Acadevic/RocketStoveDesign/README.md

This project is the creation of a rocket stove.
