Acadevic/RocketStoveDesign/Conference Paper/SAUPEC26-30-Paper.odt

Design and Validation of a Sustainable Rocket Stove for Off-Grid Cooking and Heating in Underprivileged Communities

*Note: Sub-titles are not captured in Xplore and should not be used

line 1: 1st Given Name Surname
line 2: dept. name of organization
(of Affiliation)
line 3: name of organization
(of Affiliation)
line 4: City, Country
line 5: email address or ORCID

line 1: 4th Given Name Surname
line 2: dept. name of organization
(of Affiliation)
line 3: name of organization
(of Affiliation)
line 4: City, Country
line 5: email address or ORCID

line 1: 2nd Given Name Surname
line 2: dept. name of organization
(of Affiliation)
line 3: name of organization
(of Affiliation)
line 4: City, Country
line 5: email address or ORCID

line 1: 5th Given Name Surname
line 2: dept. name of organization
(of Affiliation)
line 3: name of organization
(of Affiliation)
line 4: City, Country
line 5: email address or ORCID

line 1: 3rd Given Name Surname
line 2: dept. name of organization
(of Affiliation)
line 3: name of organization
(of Affiliation)
line 4: City, Country
line 5: email address or ORCID

line 1: 6th Given Name Surname
line 2: dept. name of organization
(of Affiliation)
line 3: name of organization
(of Affiliation)
line 4: City, Country
line 5: email address or ORCID

Abstract: Sustainable off-grid cooking remains a significant challenge for engineers: solar stoves are often too slow, while open fires are inefficient and resource-intensive. This study develops a cost-effective and safe rocket stove for frugal off-grid cooking in underprivileged communities, offering a practical alternative that delivers efficient cooking performance, preserves cultural practices, and provides a low-cost solution. An iterative approach was followed, involving requirements analysis, laboratory testing, field testing, and prototyping. The final requirements identified cooking and space heating as primary needs. Prototypes were designed and refined to assess thermal behavior according to ISO 19867, cooking capabilities following ISO 1860-1, and environmental performance using life-cycle assessment (ISO 14040). Field trials were then conducted to evaluate social integration and stakeholder satisfaction. The research resulted in the development of a sustainable, low-cost rocket stove design that complies with international standards Laboratory tests in accordance with ISO standards established safe thermal behavior, ensuring the shell remained safe to touch while enabling slow heat release for space heating. Field tests evaluated social integration and stakeholder satisfaction. Findings suggest that rocket stove technology holds considerable potential to improve cooking practices and provide household heating for South African communities lacking access to the national power grid.

Keywords—component, formatting, style, styling, insert (key words)

# Introduction

It is well known that much of Southern Africa is sparesly populated. This is not reflected in the average population per square meter since many of the large cities have now experienced rapid urbanisation. Yet, small communities still persist due to culutural nomadism or historic economic reasons such as farm hands, settlements, and towns.

1. Modest energy needs across much of the region.
  Home solarPV systems are well suited for rural settlements as they have modest energy needs of around 100 watts (Barnes et al., 2009), considering lighting, household appliances, computers, and water pumps . Note the exclusion of thermal loads.
  1. While much of the regions industrial sectors prioritize renewable energy for economic sustainability reasons (Steed et al., 2025), rural african’s do not benefit from this transition. These complexities of rural finances mean completely different financial models and incentives are being investigated (Dibaba et al., 2023).
  2. Energy justice and the JET
2. Challenges of energy infrastrucutre in micro-communities
3. The benefits of energy introduced micro-communities
  1. Social
  2. Entrepreneurial
  3. Economic, through adoption
4. Fragmented efforts and the advantage of an open platform for such integration
  Swarm grids are envisioned as a peer-to-peer energy sharing platform (Sheridan et al., 2023).
  Previous efforts like developed a SolarPV (Vermaak et al., 2025)

A roadmap is a “”

# Method

## Roadmap

A

First, confirm that you have the correct template for your paper size. This template has been tailored for output on the A4 paper size. If you are using US letter-sized paper, please close this file and download the Microsoft Word, Letter file.

## Phase 1: Solar PV for lighting and smartphone charging

The first phase of this project developed a cost-effective solar PV prototype[^1]. The prototype was installed in a community and the feedback was evaluated. The resulting post implementation feedback demonstrated the prototype met the user needs, but elicited that the community appetite was increasing.

## Phase 2: Rocket stoves for cooking and demand profiling

Recalling that in phase 1, solarPV cooking was infeasible this phase introduced a woodfired rocket stove for cooking.

### Rocket stove

This stove was designed for low-cost cooking and environmental sustainability. Secondary safety and space heating emerged as feasible requirements and were persued.

For example, local material and manufacturing methods were used. Local brush/wood was used for fuel and sand and rock was used to create a thermal battery for insulation.

### Demand profiling

As users familiarty with energy grows, so does their appetite. While many demand profile synthesizers are available for industrial systems, fewer are available for residential, and none (to the authors knowledge) are available for rural energy users. This may be due to a lack of data. Therefore, the next requirement is the measuring and monitoring of users energy usage patterns to better aid in sizing energy systems and detecting when a capacity upgrade is neededed. Feasibility revealed that this subsystem can also be used to tarrif the user, which may lead to business opportunity by monetizing the nano-energy grid.

# Results

# Conclusion

##### Acknowledgment (Heading 5)

The preferred spelling of the word “acknowledgment” in America is without an “e” after the “g”. Avoid the stilted expression “one of us (R. B. G.) thanks ...”. Instead, try “R. B. G. thanks...”. Put sponsor acknowledgments in the unnumbered footnote on the first page.

##### References

The template will number citations consecutively within brackets [1]. The sentence punctuation follows the bracket [2]. Refer simply to the reference number, as in [3]—do not use “Ref. [3]” or “reference [3]” except at the beginning of a sentence: “Reference [3] was the first ...”

Number footnotes separately in superscripts. Place the actual footnote at the bottom of the column in which it was cited. Do not put footnotes in the abstract or reference list. Use letters for table footnotes.

Unless there are six authors or more give all authors’ names; do not use “et al.”. Papers that have not been published, even if they have been submitted for publication, should be cited as “unpublished” [4]. Papers that have been accepted for publication should be cited as “in press” [5]. Capitalize only the first word in a paper title, except for proper nouns and element symbols.

For papers published in translation journals, please give the English citation first, followed by the original foreign-language citation [6].

1. G. Eason, B. Noble, and I. N. Sneddon, “On certain integrals of Lipschitz-Hankel type involving products of Bessel functions,” Phil. Trans. Roy. Soc. London, vol. A247, pp. 529–551, April 1955. (references)
2. J. Clerk Maxwell, A Treatise on Electricity and Magnetism, 3rd ed., vol. 2. Oxford: Clarendon, 1892, pp.68–73.
3. I. S. Jacobs and C. P. Bean, “Fine particles, thin films and exchange anisotropy,” in Magnetism, vol. III, G. T. Rado and H. Suhl, Eds. New York: Academic, 1963, pp. 271–350.
4. K. Elissa, “Title of paper if known,” unpublished.
5. R. Nicole, “Title of paper with only first word capitalized,” J. Name Stand. Abbrev., in press.
6. Y. Yorozu, M. Hirano, K. Oka, and Y. Tagawa, “Electron spectroscopy studies on magneto-optical media and plastic substrate interface,” IEEE Transl. J. Magn. Japan, vol. 2, pp. 740–741, August 1987 [Digests 9th Annual Conf. Magnetics Japan, p. 301, 1982].
7. M. Young, The Technical Writer’s Handbook. Mill Valley, CA: University Science, 1989.

IEEE conference templates contain guidance text for composing and formatting conference papers. Please ensure that all template text is removed from your conference paper prior to submission to the conference. Failure to remove template text from your paper may result in your paper not being published.

hgjgh

[^1] Note that prototype in this context means a fully functioning product/system.
