Acadevic/RocketStoveDesign/CAD/Design Images/Screenshot 2025-10-03 093657.jpg

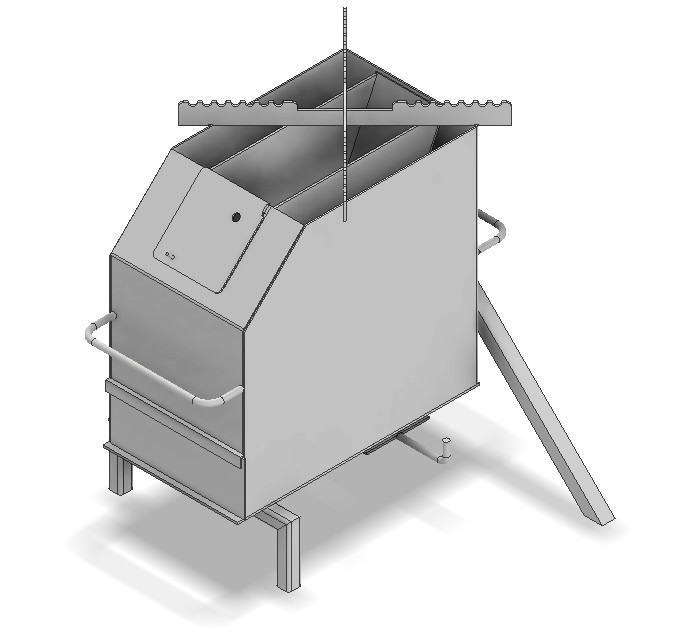
CAD/Design Images/Screenshot 2025-10-03 093657.jpg
