Acadevic/RocketStoveDesign/CAD/Design Images/View1 (1).png

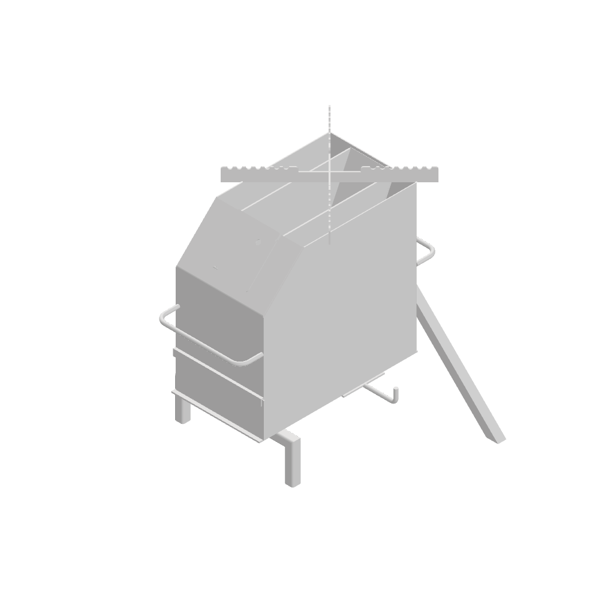
CAD/Design Images/View1 (1).png
