Acadevic/RocketStoveDesign/CAD/Design Images/View1 (2).png

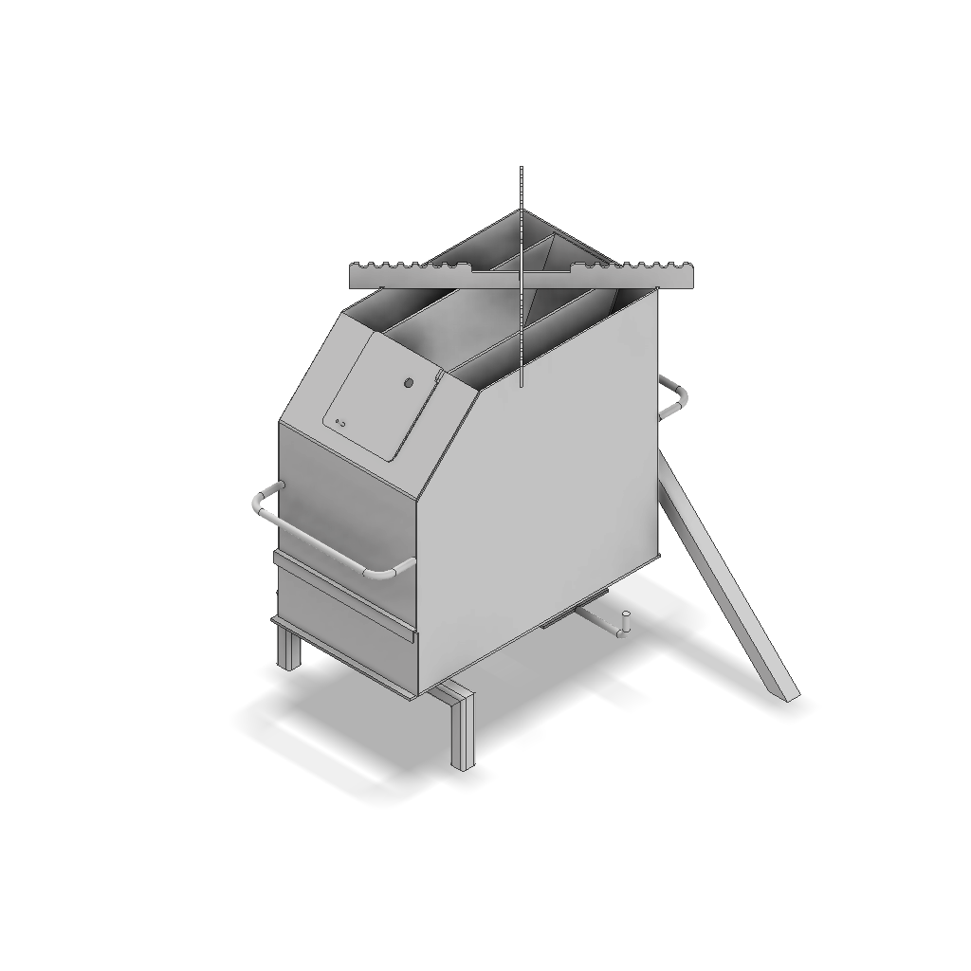
CAD/Design Images/View1 (2).png
