Acadevic/RocketStoveDesign/CAD/Design Images/View1 (3).png

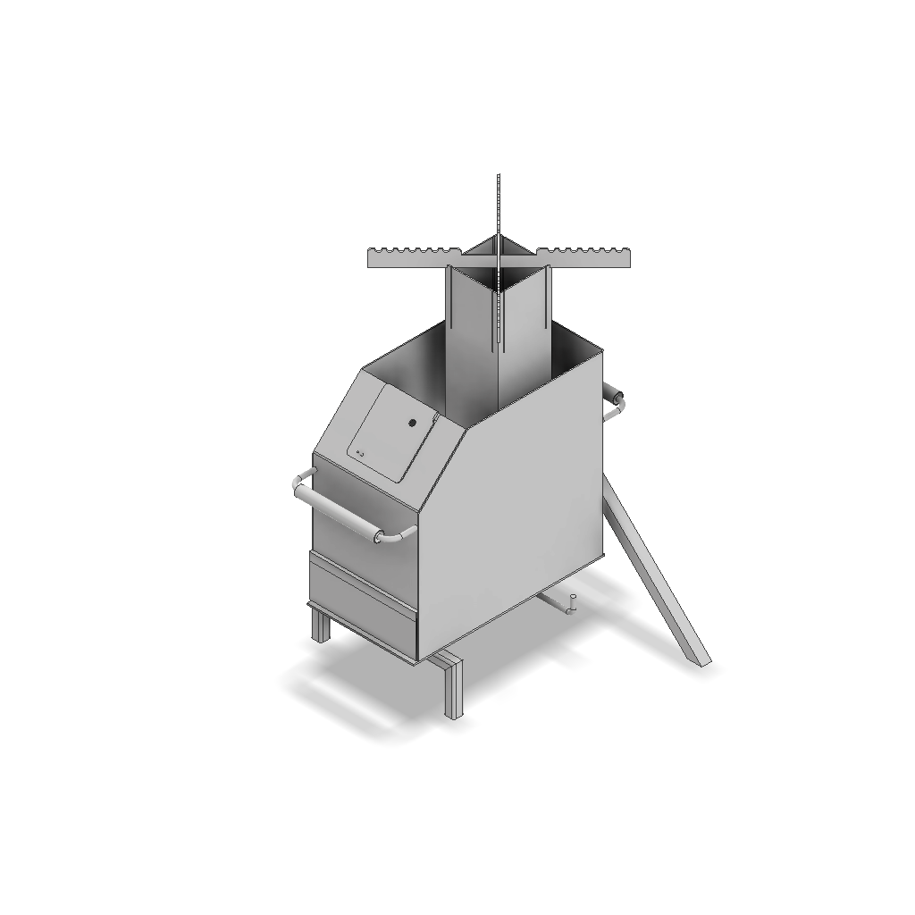
CAD/Design Images/View1 (3).png
