Acadevic/RocketStoveDesign/CAD/CAD Final Design/Workshop Blueprints/Lazercut-Parts.pdf

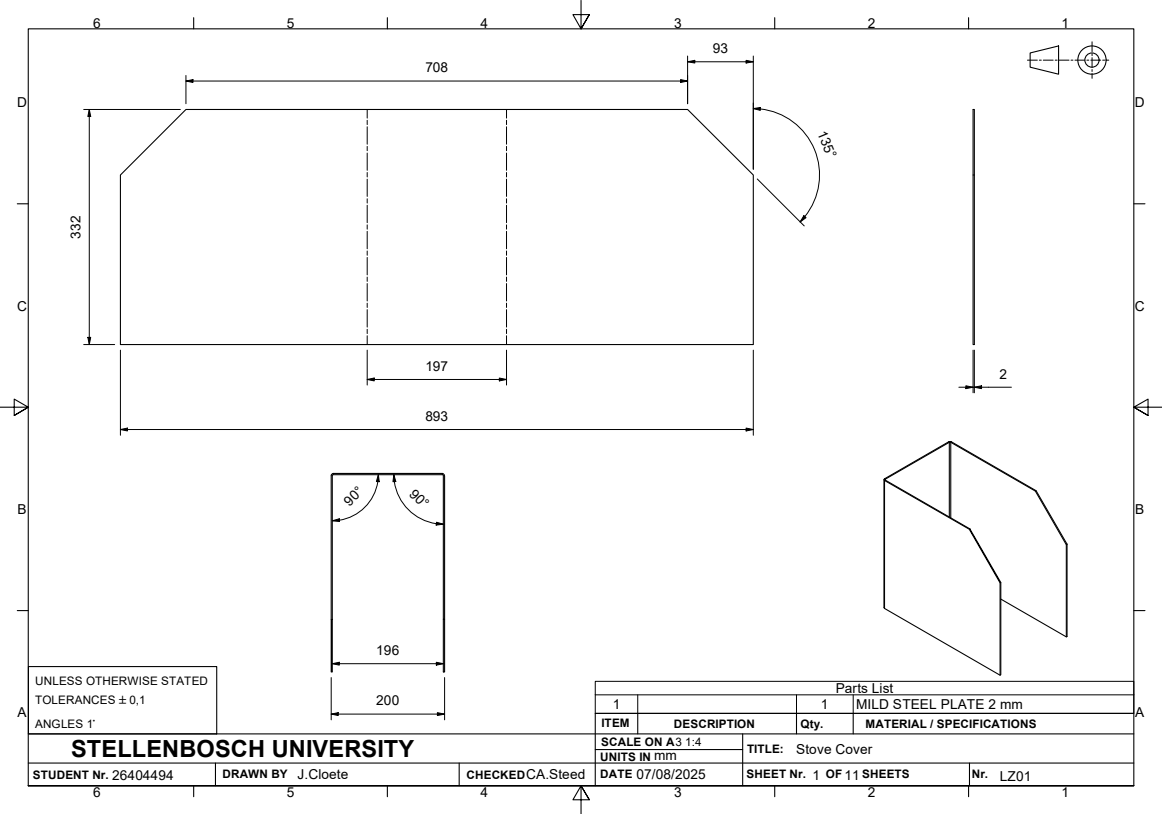
[picture p5: page 1]
Parts List; STUDENT Nr.; DRAWN BY; CHECKED; UNITS IN; SHEET Nr.; SHEETS

UNLESS OTHERWISE STATED
TOLERANCES `0,1
ANGLES 1~

1 | | 1 | MILD STEEL PLATE 2 mm
ITEM | DESCRIPTION | Qty. | MATERIAL / SPECIFICATIONS

STELLENBOSCH UNIVERSITY | SCALE ON A 3 1:4 | TITLE: Stove Cover

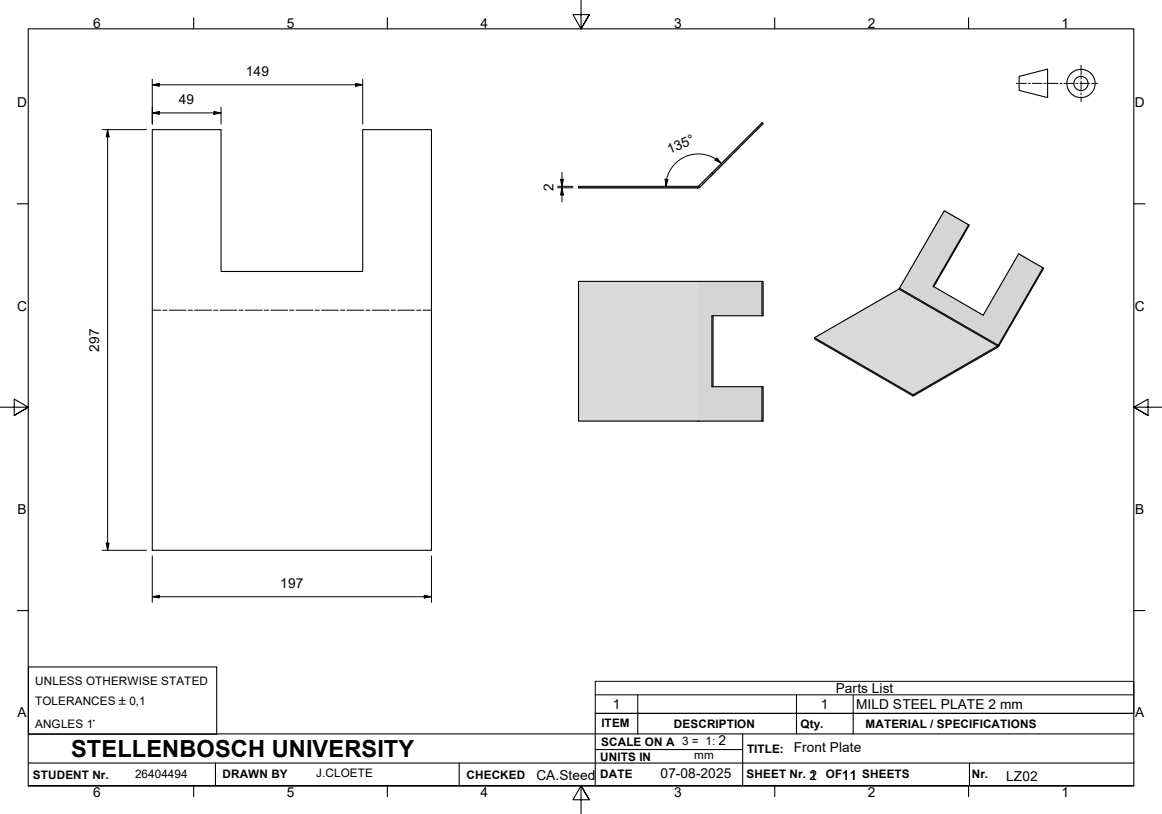
[picture p6: page 2]
Parts List

UNLESS OTHERWISE STATED
TOLERANCES `0,1
ANGLES 1~

1 | | 1 | MILD STEEL PLATE 2 mm
ITEM | DESCRIPTION | Qty. | MATERIAL / SPECIFICATIONS

STELLENBOSCH UNIVERSITY | 3 = 1: 2 SCALE ON A | Front Plate

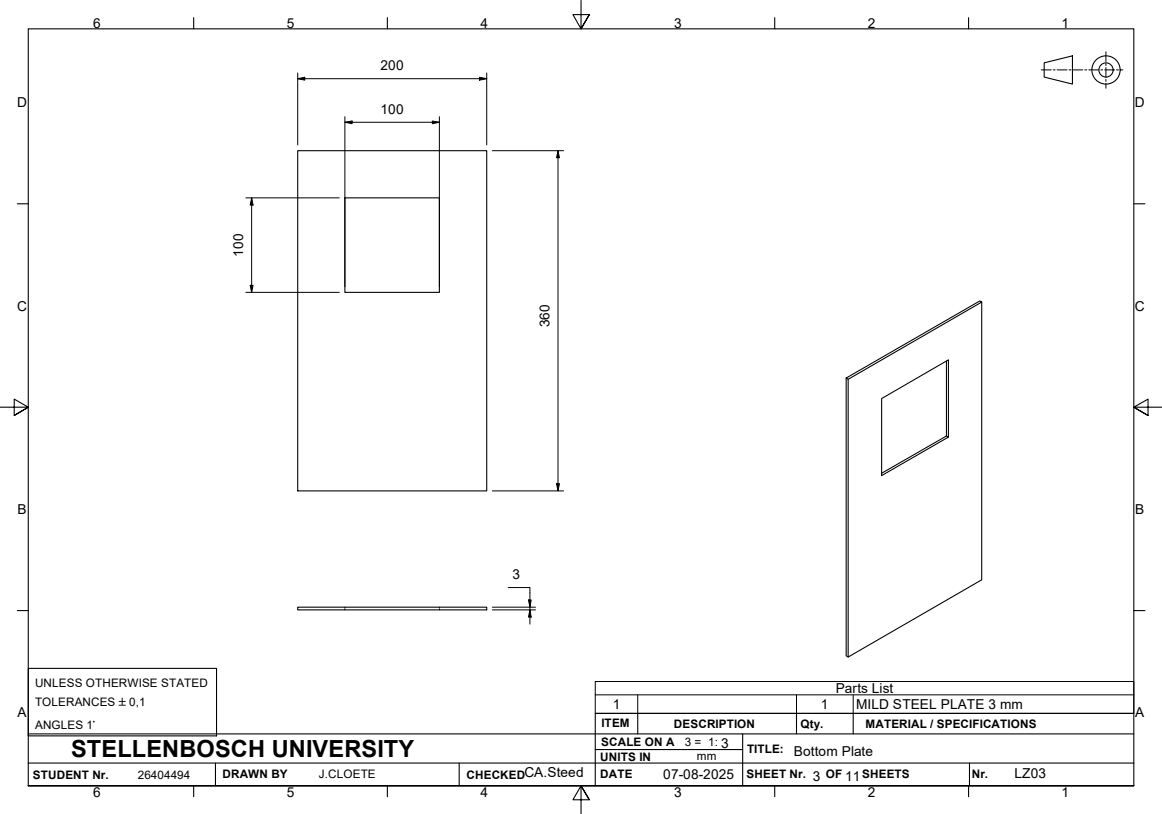
[picture p7: page 3]
Parts List

UNLESS OTHERWISE STATED
TOLERANCES `0,1
ANGLES 1~

1 | | 1 | MILD STEEL PLATE 3 mm
ITEM | DESCRIPTION | Qty. | MATERIAL / SPECIFICATIONS

STELLENBOSCH UNIVERSITY | SCALE ON A 3 = 1: 3 | Bottom Plate

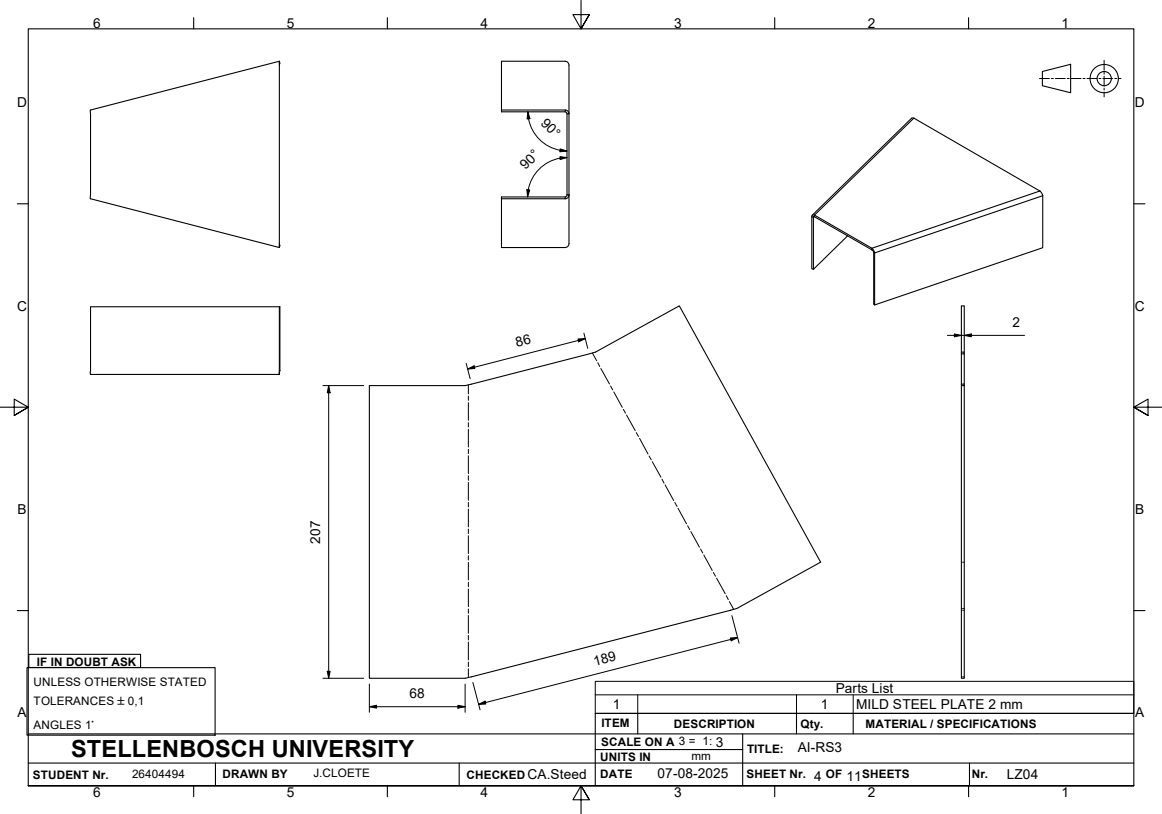
[picture p8: page 4]
Parts List

IF IN DOUBT ASK
UNLESS OTHERWISE STATED
TOLERANCES `0,1
ANGLES 1~

1 | | 1 | MILD STEEL PLATE 2 mm
ITEM | DESCRIPTION | Qty. | MATERIAL / SPECIFICATIONS

STELLENBOSCH UNIVERSITY | 3 = 1: SCALE ON A 3 | AI-RS3

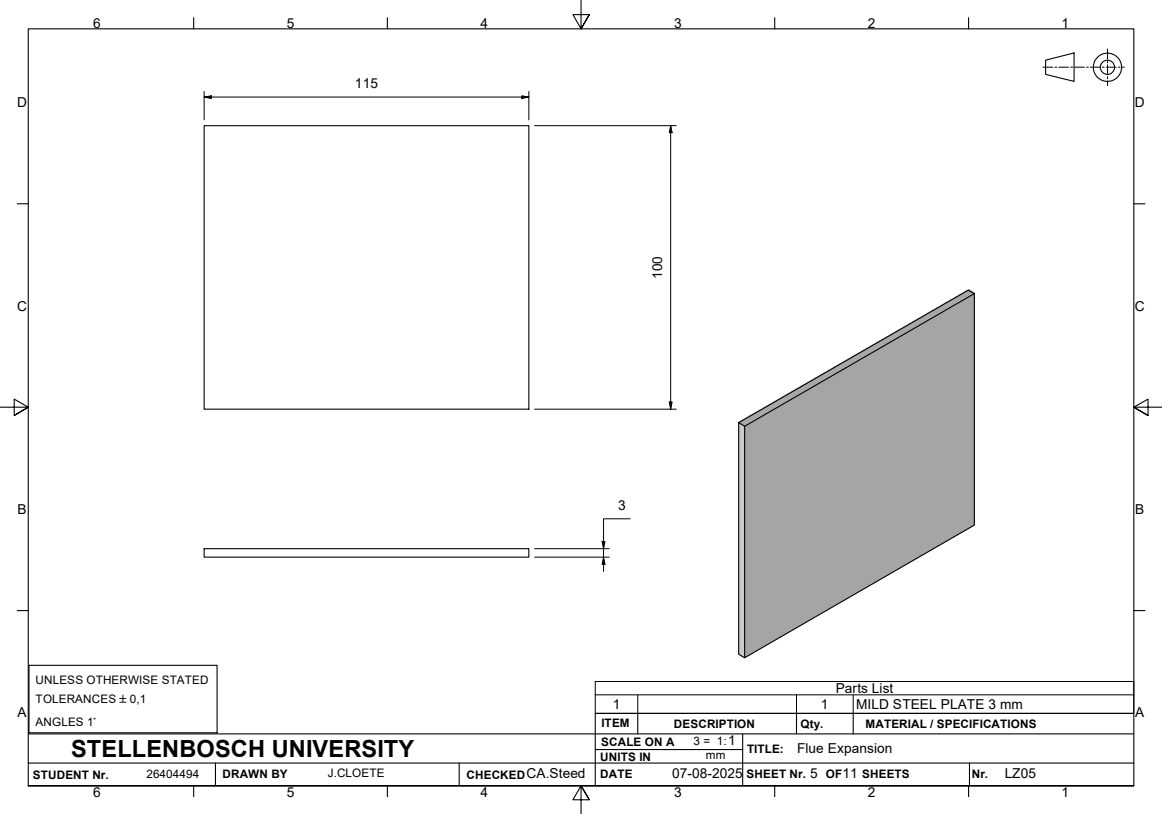
[picture p9: page 5]
Parts List

UNLESS OTHERWISE STATED
TOLERANCES `0,1
ANGLES 1~

1 | | 1 | MILD STEEL PLATE 3 mm
ITEM | DESCRIPTION | Qty. | MATERIAL / SPECIFICATIONS

STELLENBOSCH UNIVERSITY | 3 = 1: 1 SCALE ON A | Flue Expansion

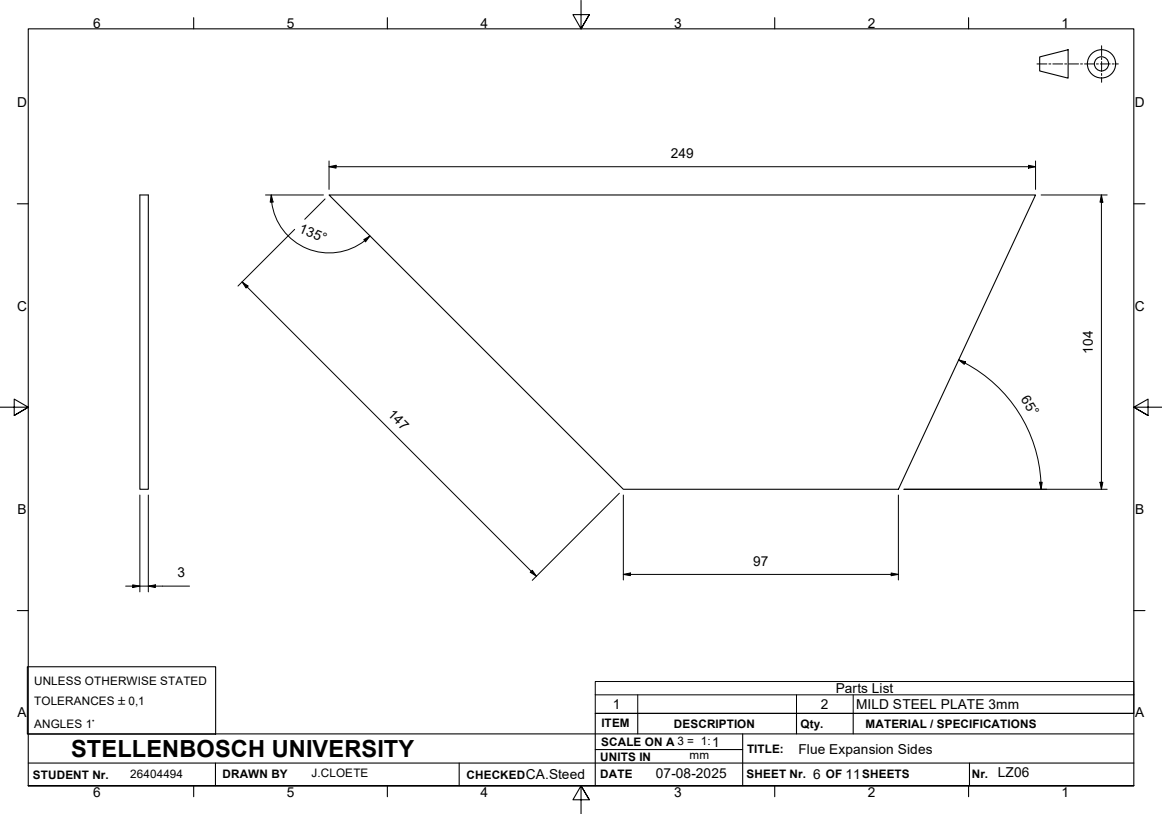
[picture p10: page 6]
Parts List

UNLESS OTHERWISE STATED
TOLERANCES `0,1
ANGLES 1~

1 | | 2 | MILD STEEL PLATE 3mm
ITEM | DESCRIPTION | Qty. | MATERIAL / SPECIFICATIONS

STELLENBOSCH UNIVERSITY | 3 = 1: SCALE ON A 1 | Flue Expansion Sides

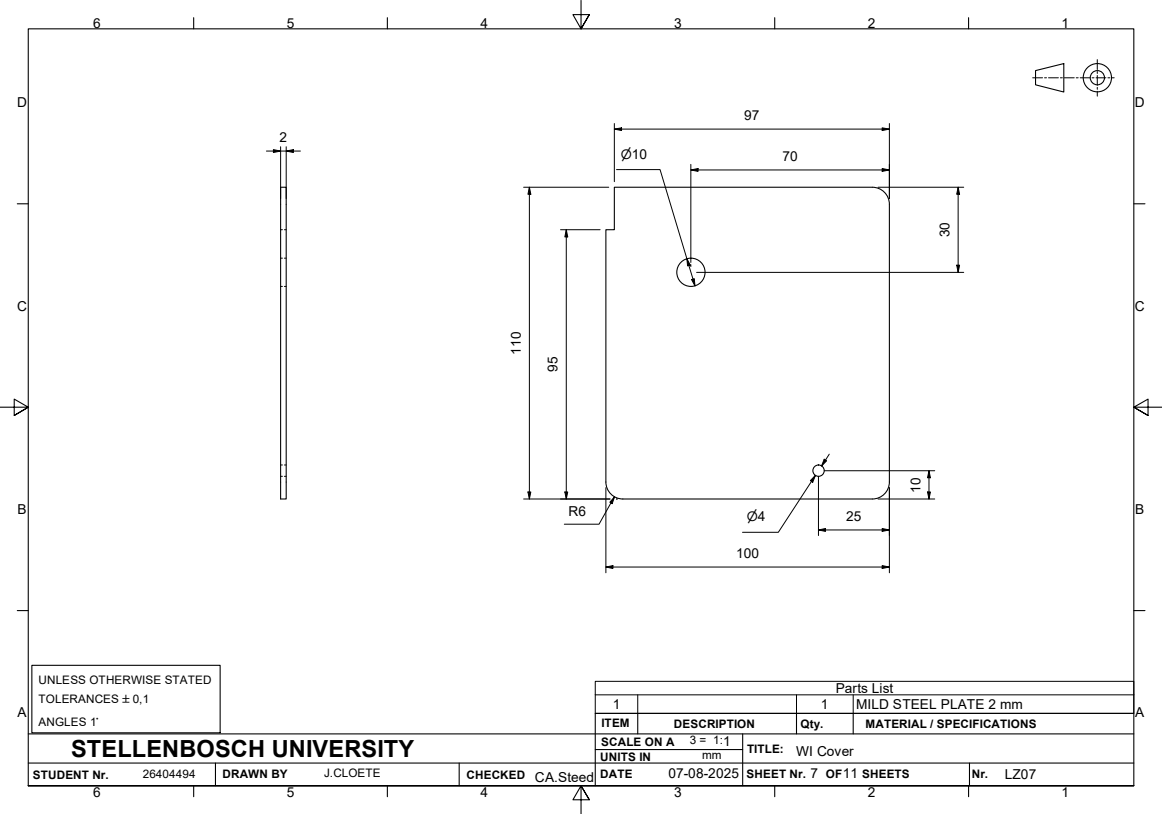
[picture p11: page 7]
Parts List

UNLESS OTHERWISE STATED
TOLERANCES `0,1
ANGLES 1~

1 | | 1 | MILD STEEL PLATE 2 mm
ITEM | DESCRIPTION | Qty. | MATERIAL / SPECIFICATIONS

STELLENBOSCH UNIVERSITY | 3 = 1: 1 SCALE ON A | WI Cover

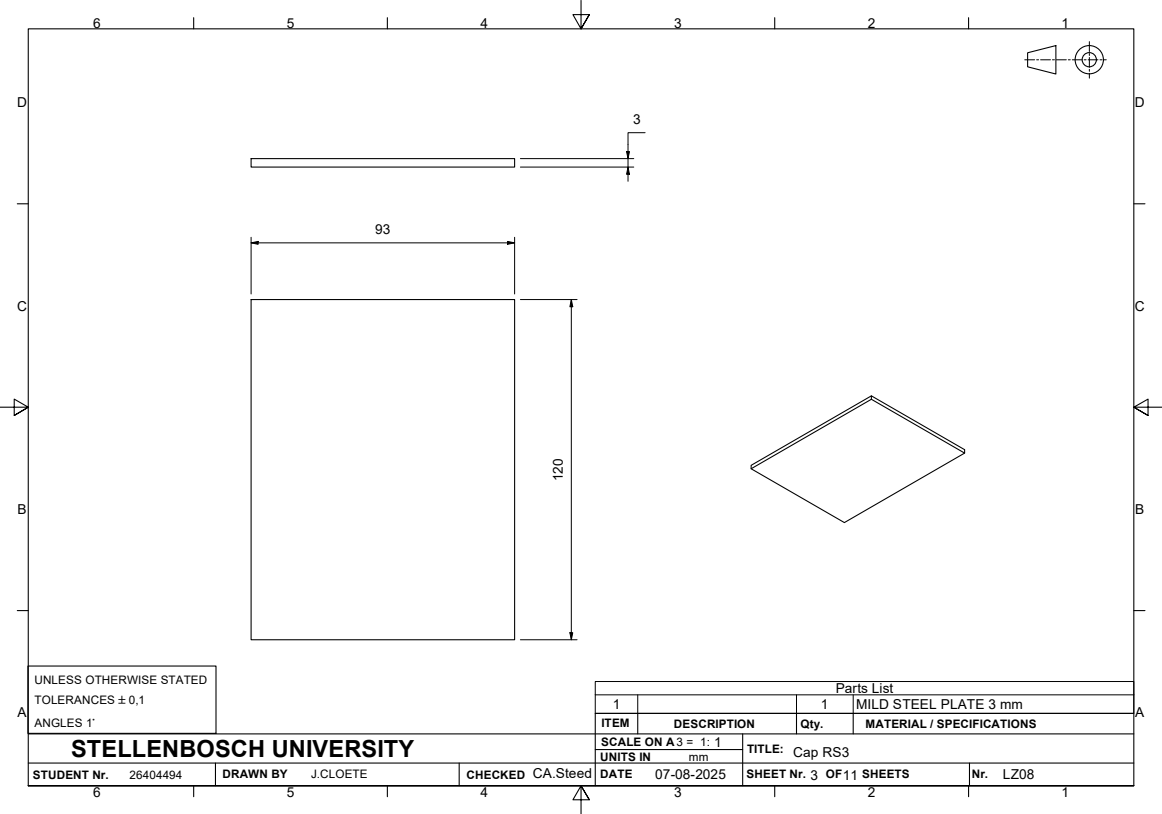
[picture p12: page 8]
Parts List

UNLESS OTHERWISE STATED
TOLERANCES `0,1
ANGLES 1~

1 | | 1 | MILD STEEL PLATE 3 mm
ITEM | DESCRIPTION | Qty. | MATERIAL / SPECIFICATIONS

STELLENBOSCH UNIVERSITY | SCALE ON A 3 = 1: 1 | Cap RS3

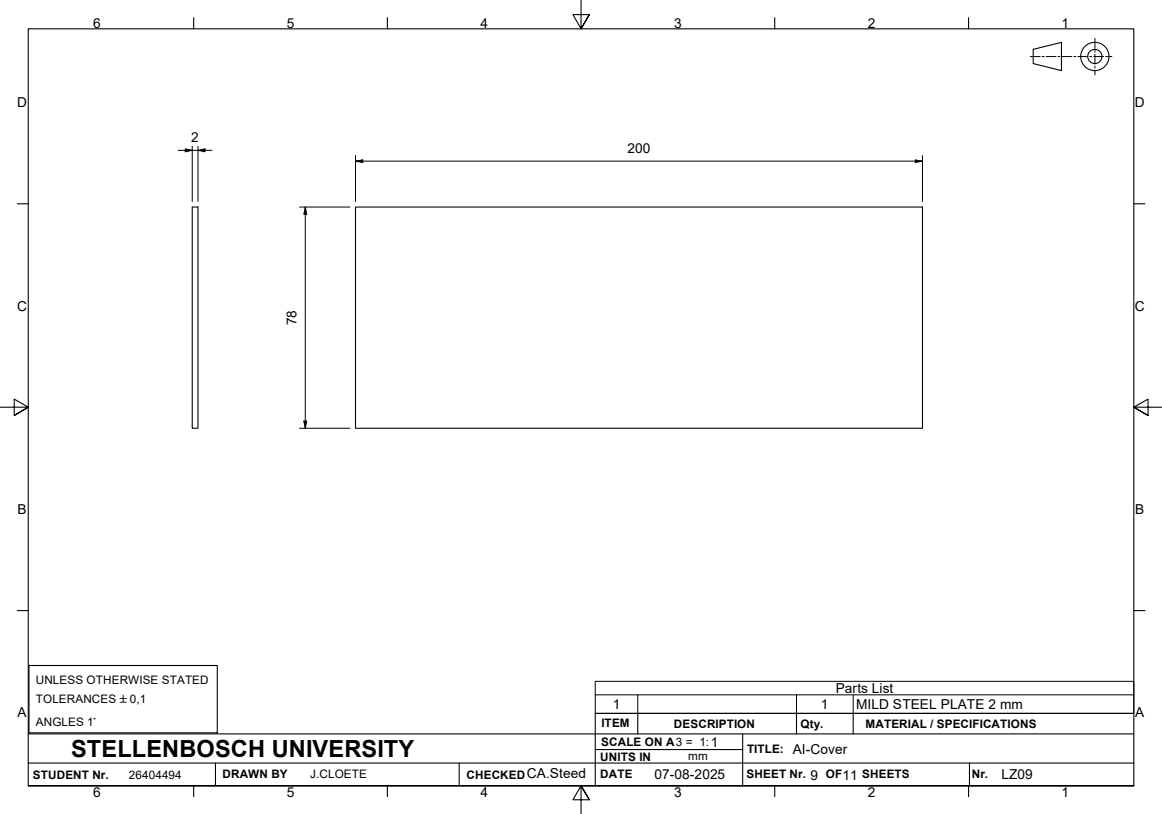
[picture p13: page 9]
Parts List

UNLESS OTHERWISE STATED
TOLERANCES `0,1
ANGLES 1~

1 | | 1 | MILD STEEL PLATE 2 mm
ITEM | DESCRIPTION | Qty. | MATERIAL / SPECIFICATIONS

STELLENBOSCH UNIVERSITY | SCALE ON A 3 = 1: 1 | AI-Cover

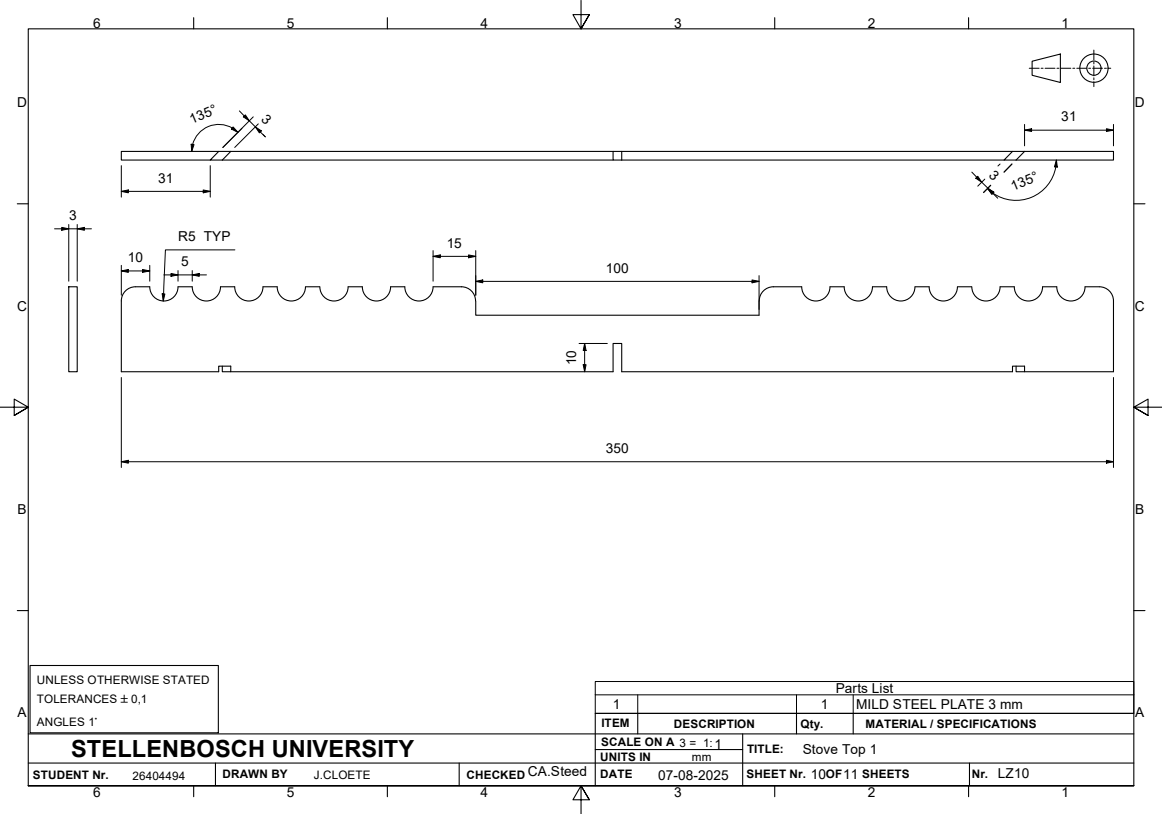
[picture p14: page 10]
Parts List; R5 TYP

UNLESS OTHERWISE STATED
TOLERANCES `0,1
ANGLES 1~

1 | | 1 | MILD STEEL PLATE 3 mm
ITEM | DESCRIPTION | Qty. | MATERIAL / SPECIFICATIONS

STELLENBOSCH UNIVERSITY | SCALE ON A 3 = 1: 1 | Stove Top 1

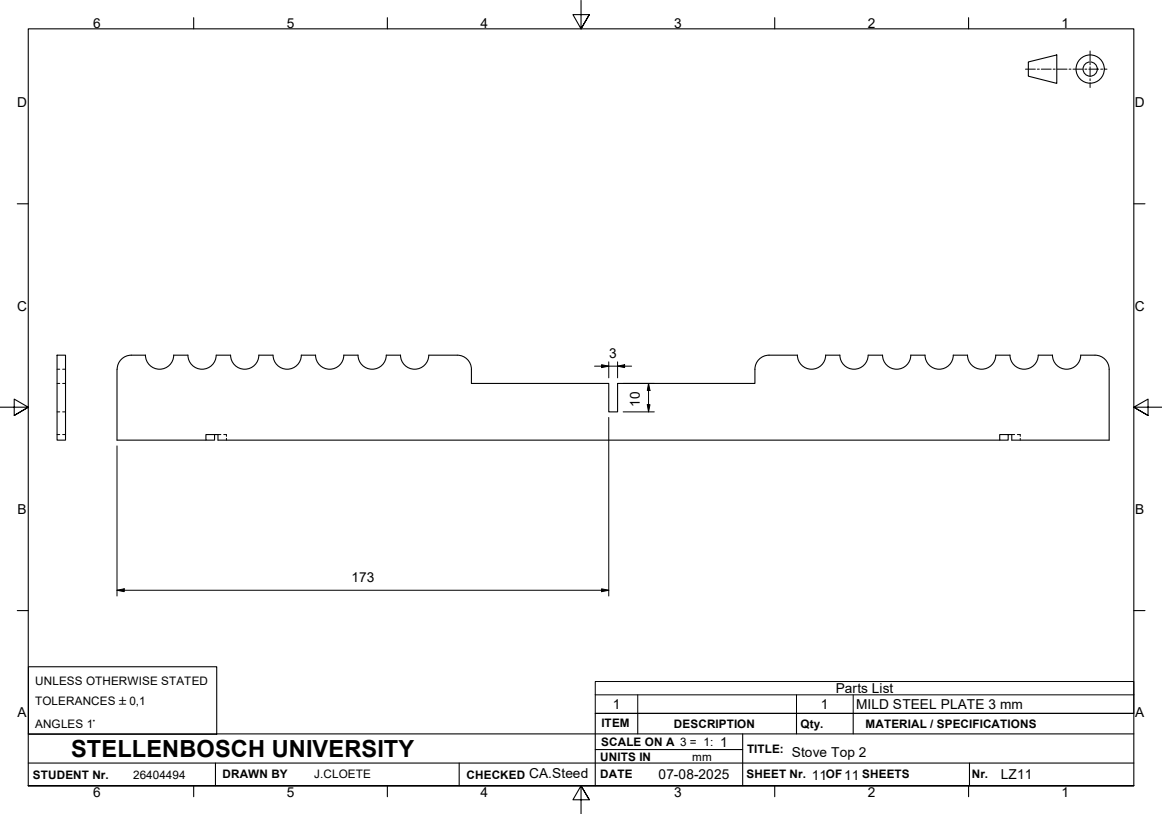
[picture p15: page 11]
Parts List

UNLESS OTHERWISE STATED
TOLERANCES `0,1
ANGLES 1~

1 | | 1 | MILD STEEL PLATE 3 mm
ITEM | DESCRIPTION | Qty. | MATERIAL / SPECIFICATIONS

STELLENBOSCH UNIVERSITY | SCALE ON A 3 = 1: 1 | Stove Top 2
