Acadevic/RocketStoveDesign/CAD/CAD Final Design/Workshop Blueprints/Lazercut-Parts_Sheet_7.dxf

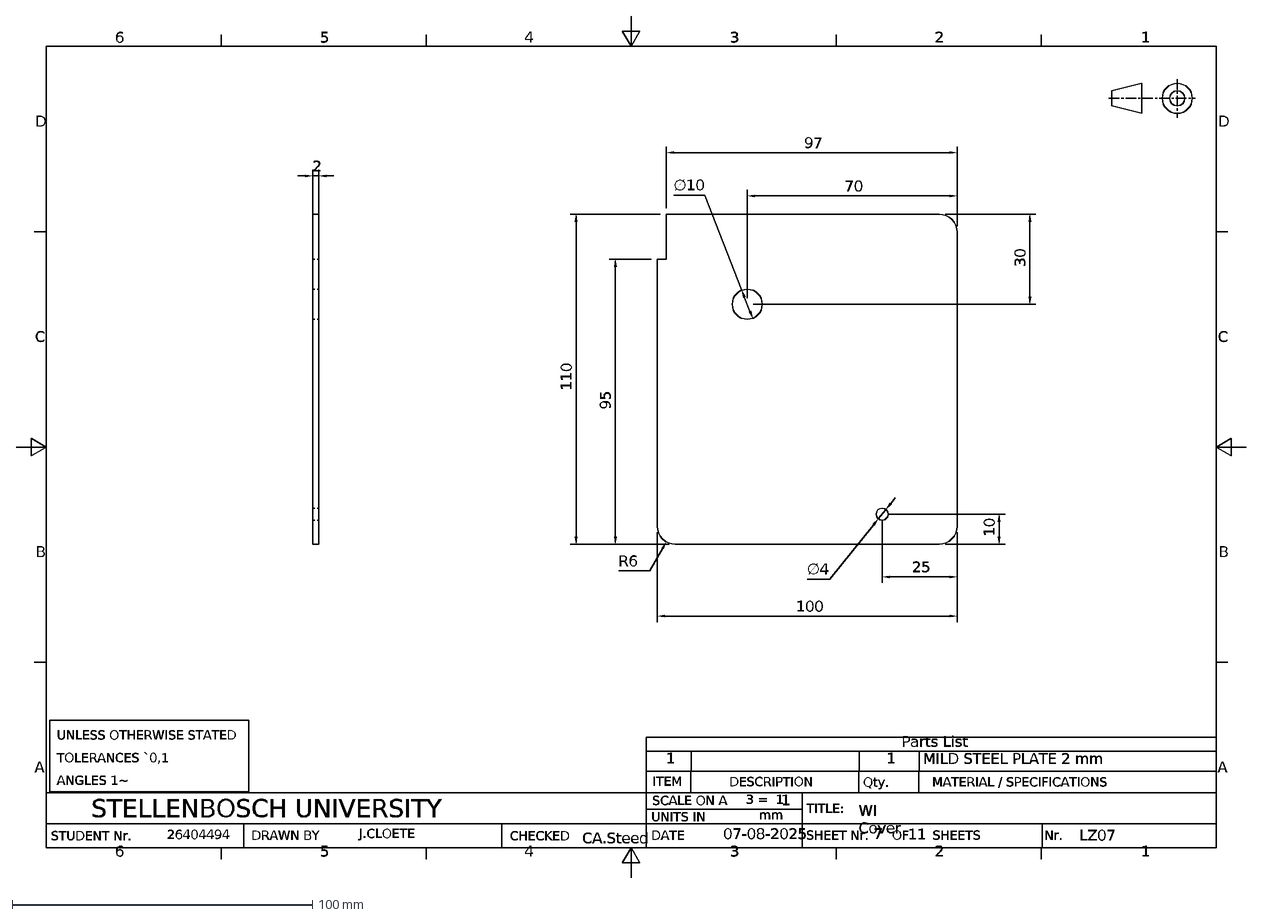
[picture p19: CAD file, 2025-10-16]
CAD/CAD Final Design/Workshop Blueprints/Lazercut-Parts_Sheet_7.dxf
1
2
3
4
5
6
A
B
C
D
STUDENT Nr.
DRAWN BY
CHECKED
ITEM
DESCRIPTION
Qty.
MATERIAL / SPECIFICATIONS
SCALE ON A
UNITS IN
SHEET Nr. OF SHEETS
Nr.
TITLE:
DATE
STELLENBOSCH UNIVERSITY
26404494
J.CLOETE
3 = 1:
mm
07-08-2025
CA.Steed
WI Cover
95
110
97
100
∅10
∅4
25
10
30
70
R6
Parts List
MILD STEEL PLATE 2 mm
11
7
LZ07
