Acadevic/RocketStoveDesign/CAD/CAD Prototype 4/Workshop Blueprints/Lazercut-Parts_Sheet_9.dxf

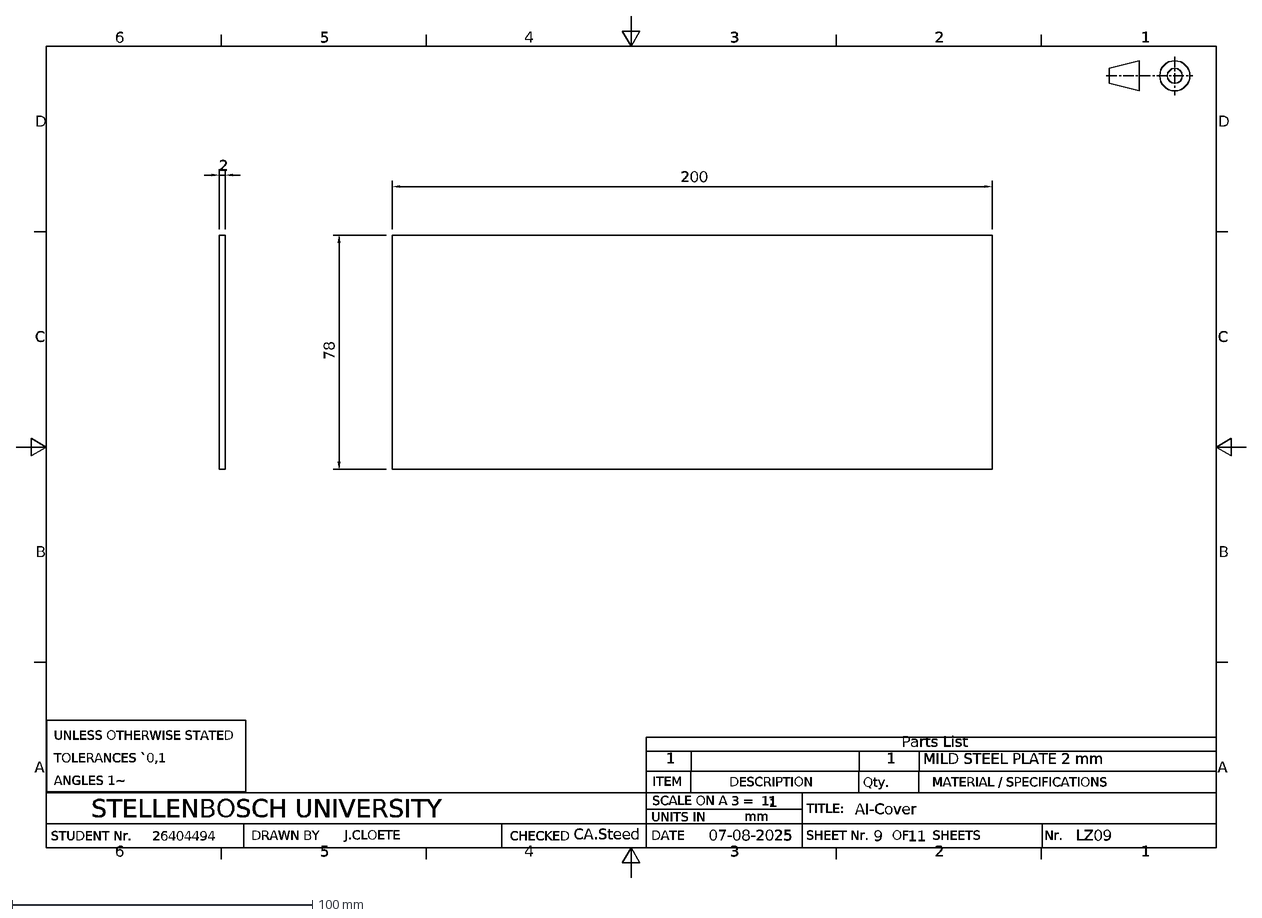
[picture p22: CAD file, 2025-10-16]
CAD/CAD Prototype 4/Workshop Blueprints/Lazercut-Parts_Sheet_9.dxf
1
2
3
4
5
6
A
B
C
D
STUDENT Nr.
DRAWN BY
CHECKED
ITEM
DESCRIPTION
Qty.
MATERIAL / SPECIFICATIONS
SCALE ON A
UNITS IN
SHEET Nr. OF SHEETS
Nr.
TITLE:
DATE
STELLENBOSCH UNIVERSITY
26404494
J.CLOETE
3 = 1:
mm
07-08-2025
CA.Steed
AI-Cover
200
78
Parts List
MILD STEEL PLATE 2 mm
11
9
LZ09
