Acadevic/RocketStoveDesign/CAD/CAD Prototype 4/Workshop Blueprints/Lazercut-Parts_Sheet_14.dxf

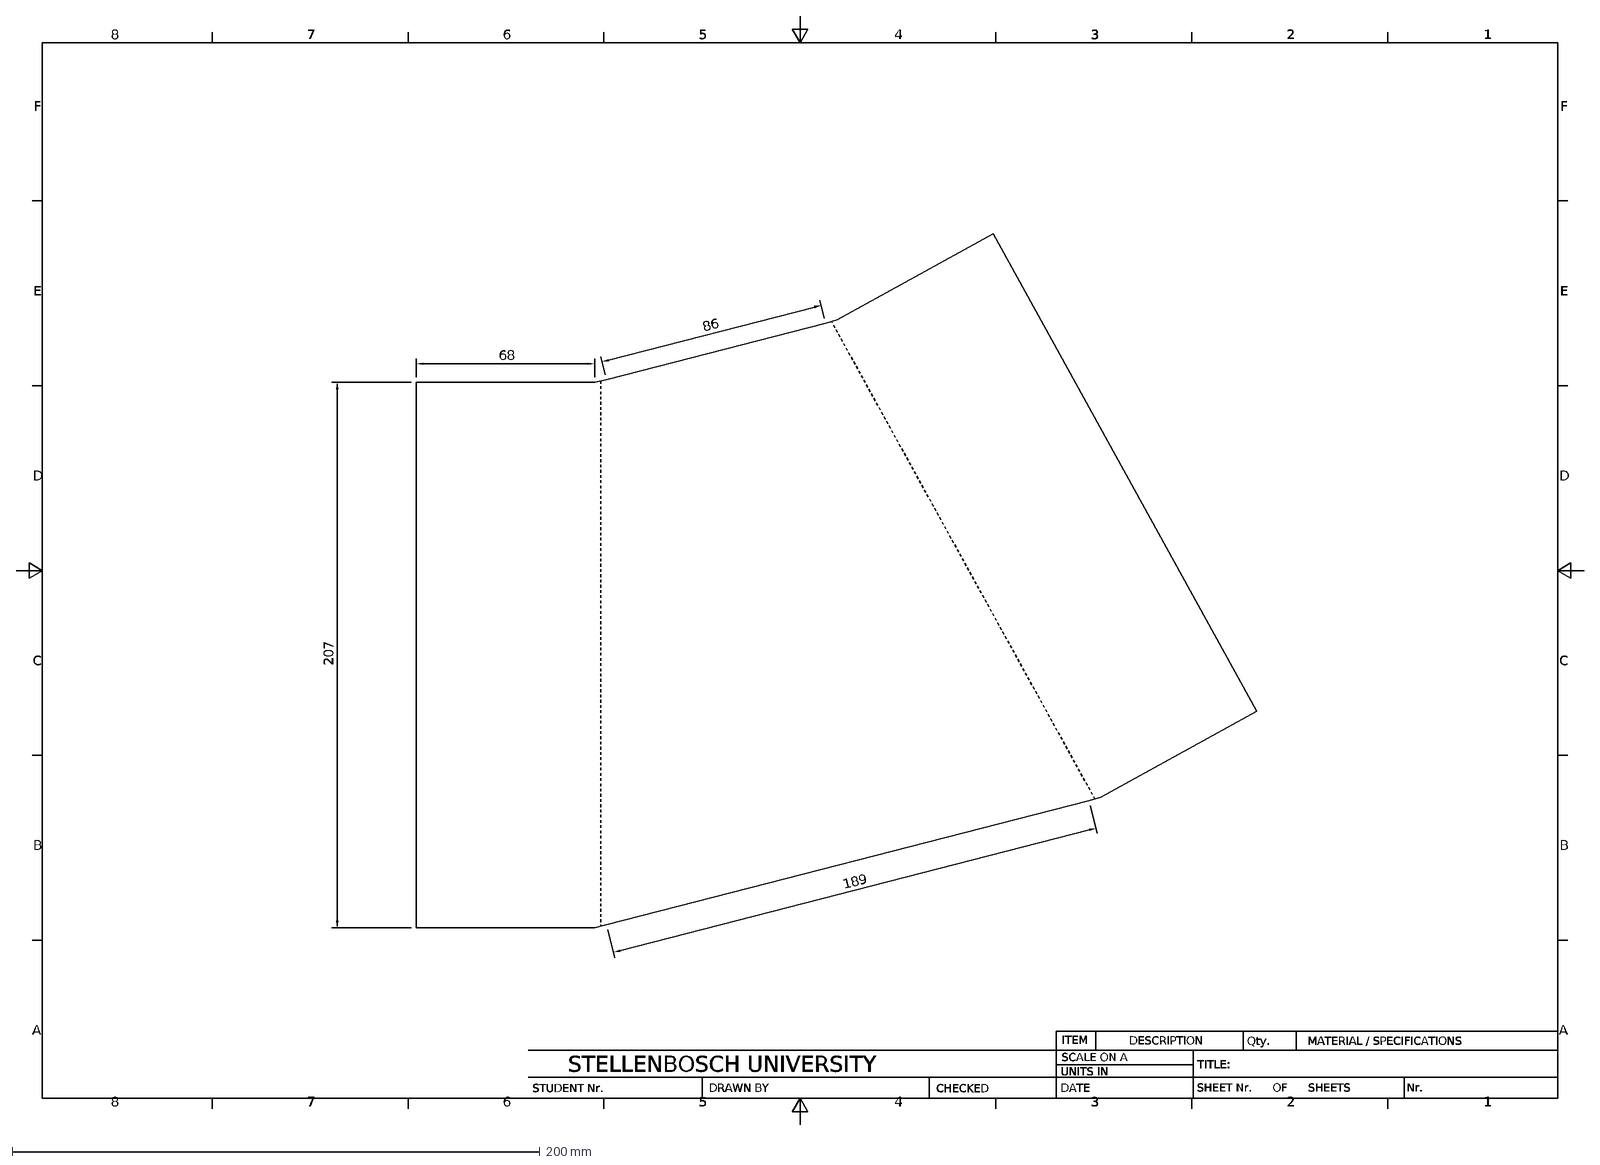
[picture p23: CAD file, 2025-10-16]
CAD/CAD Prototype 4/Workshop Blueprints/Lazercut-Parts_Sheet_14.dxf
1
2
3
4
5
6
7
8
A
B
C
D
E
F
STUDENT Nr.
DRAWN BY
CHECKED
ITEM
DESCRIPTION
Qty.
MATERIAL / SPECIFICATIONS
SCALE ON A
UNITS IN
SHEET Nr. OF SHEETS
Nr.
TITLE:
DATE
STELLENBOSCH UNIVERSITY
189
86
68
207
