Acadevic/RocketStoveDesign/CAD/CAD Final Design/Workshop Blueprints/Lazercut-Parts_Sheet_6.dxf

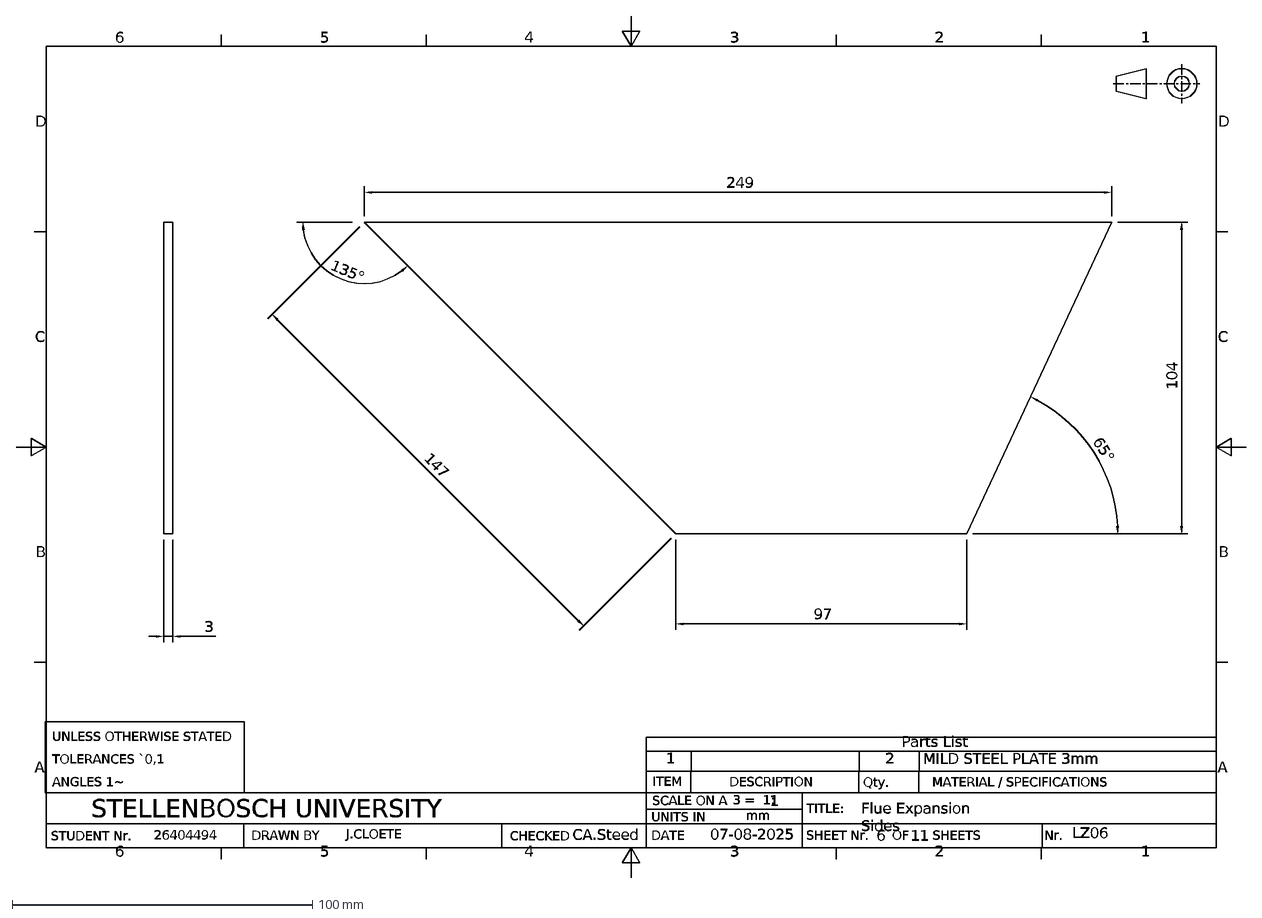
[picture p24: CAD file, 2025-10-16]
CAD/CAD Final Design/Workshop Blueprints/Lazercut-Parts_Sheet_6.dxf
1
2
3
4
5
6
A
B
C
D
STUDENT Nr.
DRAWN BY
CHECKED
ITEM
DESCRIPTION
Qty.
MATERIAL / SPECIFICATIONS
SCALE ON A
UNITS IN
SHEET Nr. OF SHEETS
Nr.
TITLE:
DATE
STELLENBOSCH UNIVERSITY
26404494
J.CLOETE
3 = 1:
mm
07-08-2025
CA.Steed
Flue Expansion Sides
135°
249
147
97
104
65°
Parts List
MILD STEEL PLATE 3mm
11
LZ06
