Acadevic/RocketStoveDesign/(list of files, cad)

Other CAD files:
CAD/CAD Final Design/Workshop Blueprints/Lazercut-Parts_Sheet_12.dxf
CAD/CAD Prototype 4/Workshop Blueprints/Lazercut-Parts_Sheet_12.dxf
CAD/CAD Final Design/AI-Cover.ipt
CAD/CAD Final Design/AI-RS3.ipt
CAD/CAD Final Design/AI-SidePlateRS3.ipt
CAD/CAD Final Design/AI-TopPlateRS3.ipt
CAD/CAD Final Design/Allen&Cap.iam
CAD/CAD Final Design/AllenKey-RS3.ipt
CAD/CAD Final Design/AshTray.ipt
CAD/CAD Final Design/AssemblyRS3.iam
CAD/CAD Final Design/AssemblyRS3/Frame/Frame 1749804902783.iam
CAD/CAD Final Design/AssemblyRS3/Frame/ISO 10799-2 100x100x3 1749804906043.ipt
CAD/CAD Final Design/AssemblyRS3/Frame/ISO 10799-2 100x100x3 1749804906153.ipt
CAD/CAD Final Design/AssemblyRS3/Frame/OldVersions/ISO 10799-2 100x100x3 1749804906043.0001.ipt
CAD/CAD Final Design/AssemblyRS3/Frame/OldVersions/ISO 10799-2 100x100x3 1749804906153.0001.ipt
CAD/CAD Final Design/AssemblyRS3/Frame/Plate Filleted Corners (mm) 1749805014766.ipt
CAD/CAD Final Design/AssemblyRS3/Frame/Skeleton 1749804902784.ipt
CAD/CAD Final Design/BottomPlateRS3.ipt
CAD/CAD Final Design/CapRS3.ipt
CAD/CAD Final Design/Conmcept 4-Assembly.iam
CAD/CAD Final Design/Conmcept 4-Assembly.ipn
CAD/CAD Final Design/Conmcept 4-Assembly.newVer.iam
CAD/CAD Final Design/ConstructPlate2.ipt
CAD/CAD Final Design/ConstructionPlane1.ipt
CAD/CAD Final Design/Drawing Templates-20240528 (1)/Stellenbosch A3 English.idw
CAD/CAD Final Design/Drawing Templates-20240528 (1)/Stellenbosch A3.idw
CAD/CAD Final Design/Drawing Templates-20240528 (1)/Stellenbosch A4 English.idw
CAD/CAD Final Design/Drawing Templates-20240528 (1)/Stellenbosch A4.idw
CAD/CAD Final Design/FLU-BackPlateRS3.ipt
CAD/CAD Final Design/FLU-ShaftRS3.ipt
CAD/CAD Final Design/FLU-SidePlatesRS3.ipt
CAD/CAD Final Design/FLueExtension.ipt
CAD/CAD Final Design/Flu-Expansion-RS3.ipt
CAD/CAD Final Design/Flu-ExpansionSides RS3.ipt
CAD/CAD Final Design/Flu-ExpansionSidesRS3.ipt
CAD/CAD Final Design/FootRS3.iam
CAD/CAD Final Design/FootRS3/Frame/Frame 1750167718332.iam
CAD/CAD Final Design/FootRS3/Frame/ISO 10799-2 20x20x2 1750167720305.ipt
CAD/CAD Final Design/FootRS3/Frame/ISO 10799-2 20x20x2 1750167720397.ipt
CAD/CAD Final Design/FootRS3/Frame/ISO 10799-2 20x20x2 1750167720494.ipt
CAD/CAD Final Design/FootRS3/Frame/OldVersions/Frame 1750167718332.0001.iam
CAD/CAD Final Design/FootRS3/Frame/OldVersions/ISO 10799-2 20x20x2 1750167720305.0001.ipt
CAD/CAD Final Design/FootRS3/Frame/OldVersions/ISO 10799-2 20x20x2 1750167720397.0001.ipt
CAD/CAD Final Design/FootRS3/Frame/OldVersions/ISO 10799-2 20x20x2 1750167720494.0001.ipt
CAD/CAD Final Design/FootRS3/Frame/OldVersions/Skeleton 1750167718333.0001.ipt
CAD/CAD Final Design/FootRS3/Frame/Skeleton 1750167718333.ipt
CAD/CAD Final Design/Front cover.ipt
CAD/CAD Final Design/Full-Assembly.idw
CAD/CAD Final Design/Grid RS3.ipt
CAD/CAD Final Design/GuiderailRS3.ipt
CAD/CAD Final Design/GuiderodsRS3.ipt
CAD/CAD Final Design/Handle.ipt
CAD/CAD Final Design/Lazercut-Parts.idw
CAD/CAD Final Design/LzC-Assembly.iam
CAD/CAD Final Design/LzC-Assembly.idw
CAD/CAD Final Design/LzC-Assmbly Construction.iam
CAD/CAD Final Design/LzC-Assmbly Detail.iam
CAD/CAD Final Design/LzC-FrontPLateRS3.ipt
CAD/CAD Final Design/LzC-StoveCover.ipt
CAD/CAD Final Design/OldVersions/AI-Cover.0003.ipt
CAD/CAD Final Design/OldVersions/AI-RS3.0004.ipt
CAD/CAD Final Design/OldVersions/AI-SidePlateRS3.0001.ipt
CAD/CAD Final Design/OldVersions/AI-TopPlateRS3.0001.ipt
CAD/CAD Final Design/OldVersions/Allen&Cap.0001.iam
CAD/CAD Final Design/OldVersions/AllenKey-RS3.0004.ipt
CAD/CAD Final Design/OldVersions/AshTray.0001.ipt
CAD/CAD Final Design/OldVersions/AssemblyRS3.0001.iam
CAD/CAD Final Design/OldVersions/BottomPlateRS3.0005.ipt
CAD/CAD Final Design/OldVersions/CapRS3.0006.ipt
CAD/CAD Final Design/OldVersions/Conmcept 4-Assembly.0002.ipn
CAD/CAD Final Design/OldVersions/FLU-ShaftRS3.0008.ipt
CAD/CAD Final Design/OldVersions/FLU-SidePlatesRS3.0001.ipt
CAD/CAD Final Design/OldVersions/FLueExtension.0003.ipt
CAD/CAD Final Design/OldVersions/Flu-Expansion-RS3.0001.ipt
CAD/CAD Final Design/OldVersions/Flu-ExpansionSidesRS3.0002.ipt
CAD/CAD Final Design/OldVersions/FootRS3.0001.iam
CAD/CAD Final Design/OldVersions/Front cover.0001.ipt
CAD/CAD Final Design/OldVersions/Full-Assembly.0007.idw
CAD/CAD Final Design/OldVersions/Grid RS3.0003.ipt
CAD/CAD Final Design/OldVersions/GuiderailRS3.0001.ipt
CAD/CAD Final Design/OldVersions/GuiderodsRS3.0002.ipt
CAD/CAD Final Design/OldVersions/Handle.0001.ipt
CAD/CAD Final Design/OldVersions/Lazercut-Parts.0004.idw
CAD/CAD Final Design/OldVersions/LzC-Assembly.0001.ipn
CAD/CAD Final Design/OldVersions/LzC-Assembly.0016.iam
CAD/CAD Final Design/OldVersions/LzC-Assmbly Construction.0013.iam
CAD/CAD Final Design/OldVersions/LzC-Assmbly Detail.0014.iam
CAD/CAD Final Design/OldVersions/LzC-FrontPLateRS3.0004.ipt
CAD/CAD Final Design/OldVersions/LzC-StoveCover.0006.ipt
CAD/CAD Final Design/OldVersions/RS3_TubeFoot.0004.ipt
CAD/CAD Final Design/OldVersions/ScrapAssemblyRS3.0001.iam
CAD/CAD Final Design/OldVersions/ScraperRS3.0001.ipt
CAD/CAD Final Design/OldVersions/StoveTop.0001.ipt
CAD/CAD Final Design/OldVersions/StoveTop1.0003.ipt
CAD/CAD Final Design/OldVersions/StoveTop2.0003.ipt
CAD/CAD Final Design/OldVersions/StoveTopAssembly.ipt.0002.iam
CAD/CAD Final Design/OldVersions/WI-Cover.0002.ipt
CAD/CAD Final Design/OldVersions/WI-CoverRS3.0001.ipt
CAD/CAD Final Design/OldVersions/WI-ShaftRS3.0002.ipt
CAD/CAD Final Design/OldVersions/WireFrameRS3.0002.ipt
CAD/CAD Final Design/OldVersions/Workshop-Parts.0001.idw
CAD/CAD Final Design/OldVersions/pin.0004.ipt
CAD/CAD Final Design/OldVersions/skeletonfoot.0002.ipt
CAD/CAD Final Design/RS3-FullAs.iam
CAD/CAD Final Design/RS3_TubeFoot.iam
CAD/CAD Final Design/RS3_TubeFoot.ipt
CAD/CAD Final Design/RS3other/LzC-Assembly.ipn
CAD/CAD Final Design/ScrapAssemblyRS3.iam
CAD/CAD Final Design/Sleeve.ipt
CAD/CAD Final Design/StoveTop1.ipt
CAD/CAD Final Design/StoveTop2.ipt
CAD/CAD Final Design/StoveTopAssembly.ipt.iam
CAD/CAD Final Design/Template.idw
CAD/CAD Final Design/WI-Cover.ipt
CAD/CAD Final Design/WI-CoverRS3.ipt
CAD/CAD Final Design/WI-ShaftRS3.ipt
CAD/CAD Final Design/WireFrameRS3.ipt
CAD/CAD Final Design/Workshop-Parts.idw
CAD/CAD Final Design/pin.ipt
CAD/CAD Final Design/skeletonfoot.ipt
CAD/CAD Prototype 1/AirIntake.ipt
CAD/CAD Prototype 1/Air_Cotrol.ipt
CAD/CAD Prototype 1/Bottom_plate.ipt
CAD/CAD Prototype 1/Cook-Assembly.iam
CAD/CAD Prototype 1/Cooking Pipe.ipt
CAD/CAD Prototype 1/Feul_ClosePlate.ipt
CAD/CAD Prototype 1/Feul_Intake.ipt
CAD/CAD Prototype 1/Full-Assembly1.dwg
CAD/CAD Prototype 1/Full-Assembly1.iam
CAD/CAD Prototype 1/Insulation Shaft.ipt
CAD/CAD Prototype 1/OldVersions/AirIntake.0002.ipt
CAD/CAD Prototype 1/OldVersions/Bottom_plate.0001.ipt
CAD/CAD Prototype 1/OldVersions/Cook-Assembly.0001.iam
CAD/CAD Prototype 1/OldVersions/Cooking Pipe.0001.ipt
CAD/CAD Prototype 1/OldVersions/Feul_ClosePlate.0001.ipt
CAD/CAD Prototype 1/OldVersions/Feul_Intake.0001.ipt
CAD/CAD Prototype 1/OldVersions/Full-Assembly1.0005.iam
CAD/CAD Prototype 1/OldVersions/Insulation Shaft.0002.ipt
CAD/CAD Prototype 1/OldVersions/Outer shaft.0002.ipt
CAD/CAD Prototype 1/OldVersions/PotStand.0001.ipt
CAD/CAD Prototype 1/OldVersions/Slant.0001.ipt
CAD/CAD Prototype 1/OldVersions/VerticalShaft.0002.ipt
CAD/CAD Prototype 1/Outer shaft.ipt
CAD/CAD Prototype 1/PotStand.ipt
CAD/CAD Prototype 1/Slant.ipt
CAD/CAD Prototype 1/VerticalShaft.ipt
CAD/CAD Prototype 2/OldVersions/RS2_Assembly.0003.iam
CAD/CAD Prototype 2/OldVersions/RS2_Assembly.0005.idw
CAD/CAD Prototype 2/OldVersions/RS2_Full Assembly.0002.iam
CAD/CAD Prototype 2/OldVersions/RS2_Parts.0003.idw
CAD/CAD Prototype 2/OldVersions/RS2_Skeleton3rdFoot.0001.ipt
CAD/CAD Prototype 2/OldVersions/RS2_SkeletonFoot.0001.ipt
CAD/CAD Prototype 2/OldVersions/RS2_Tube3rdFoot.0004.iam
CAD/CAD Prototype 2/OldVersions/RS2_TubeFoot.0001.iam
CAD/CAD Prototype 2/OldVersions/RS2_TubeFoot.0001.ipt
CAD/CAD Prototype 2/OldVersions/RS2_TubeFoot.0001_1.iam
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
