Acadevic/RocketStoveDesign/CAD/CAD Final Design/Workshop Blueprints/Full-Assembly.pdf

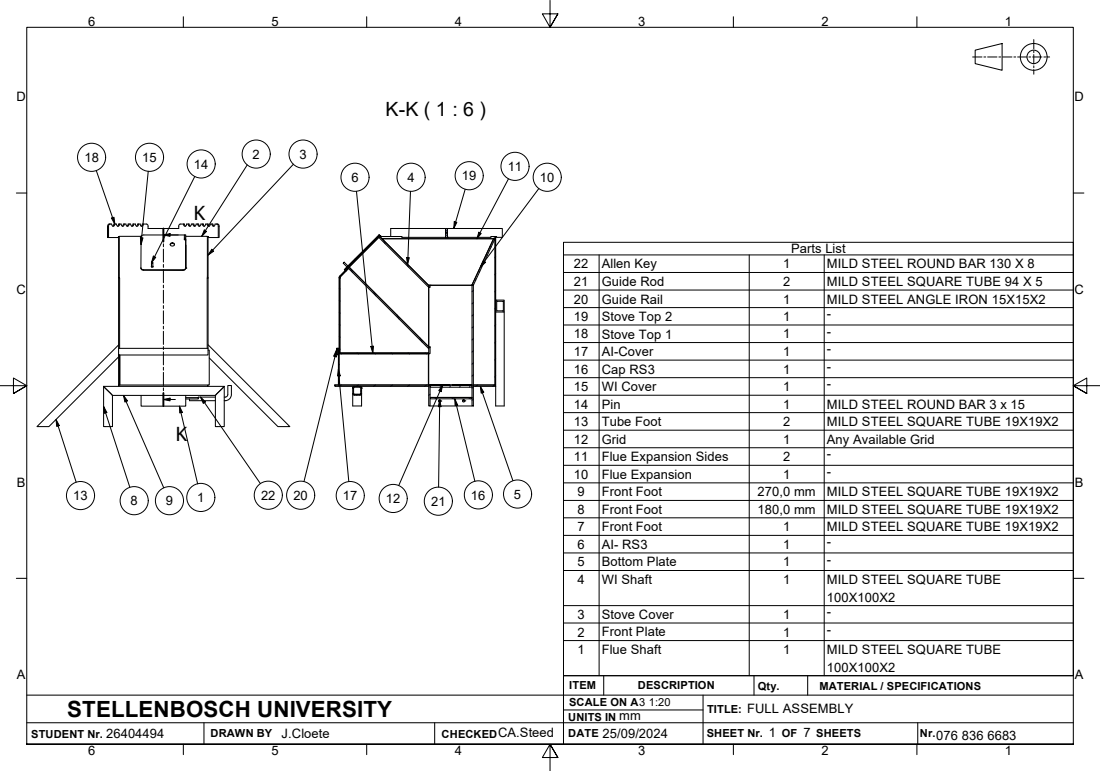
[picture p26: page 1]
Parts List; STUDENT Nr.; DRAWN BY; CHECKED; UNITS IN; SHEET Nr.; SHEETS

22 | Allen Key | 1 | MILD STEEL ROUND BAR 130 X 8
21 | Guide Rod | 2 | MILD STEEL SQUARE TUBE 94 X 5
20 | Guide Rail | 1 | MILD STEEL ANGLE IRON 15X15X2
S tove Top 2 | 1 | - 19
S tove Top 1 | 1 | - 18
A I-Cover | 1 | - 17
16 | Cap RS3 | 1 | -
W I Cover | 1 | - 15
14 | Pin | 1 | MILD STEEL ROUND BAR 3 x 15
13 | Tube Foot | 2 | MILD STEEL SQUARE TUBE 19X19X2
12 | Grid | 1 | Any Available Grid
F lue Expansion Sides | 2 | - 11
F lue Expansion | 1 | - 10
9 | Front Foot | 270,0 mm | MILD STEEL SQUARE TUBE 19X19X2
8 | Front Foot | 180,0 mm | MILD STEEL SQUARE TUBE 19X19X2
7 | Front Foot | 1 | MILD STEEL SQUARE TUBE 19X19X2
A I- RS3 | 1 | - 6
Bo ttom Plate | 1 | - 5
4 | WI Shaft | 1 | MILD STEEL SQUARE TUBE 100X100X2

S tove Cover | 1 | - 3
F ront Plate | 1 | - 2
1 | Flue Shaft | 1 | MILD STEEL SQUARE TUBE 100X100X2

ITEM | DESCRIPTION | Qty. | MATERIAL / SPECIFICATIONS

STELLENBOSCH UNIVERSITY | SCALE ON A 3 1:20 | TITLE: FULL ASSEMBLY

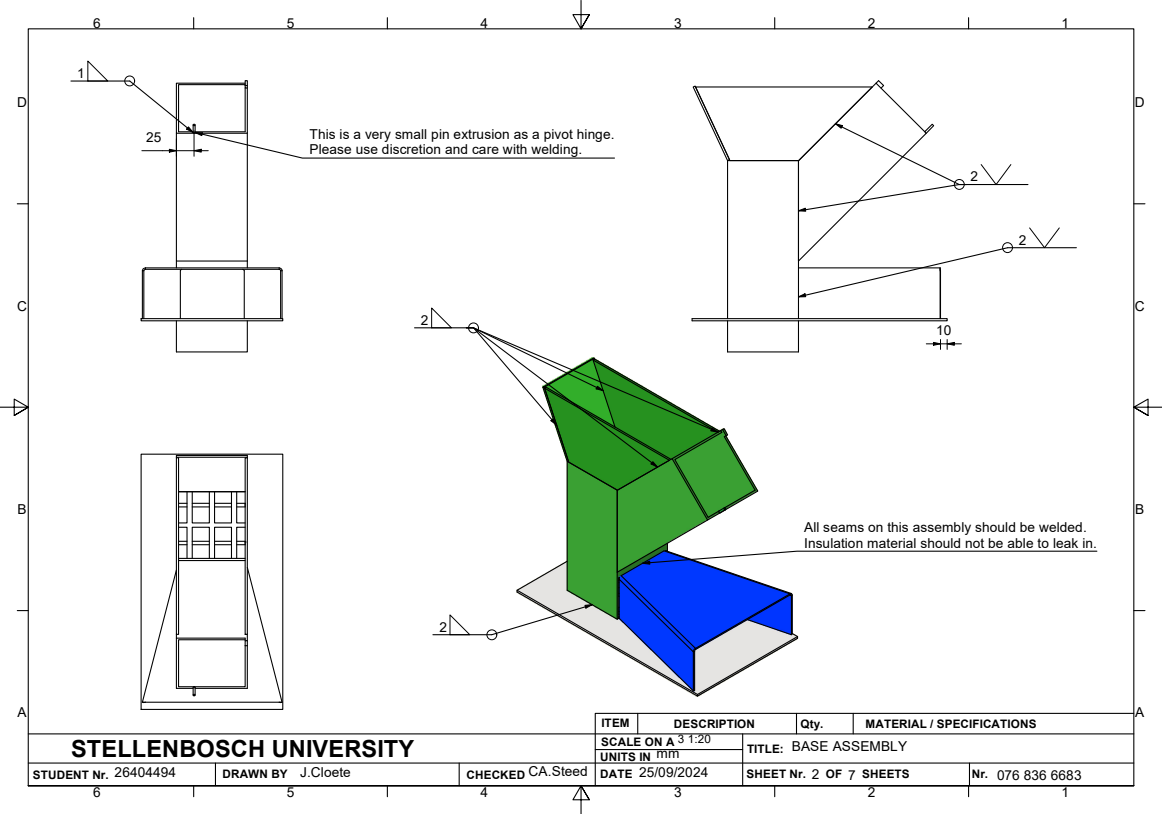
[picture p27: page 2]

This is a very small pin extrusion as a pivot hinge.
Please use discretion and care with welding.

All seams on this assembly should be welded.
Insulation material should not be able to leak in.

ITEM | DESCRIPTION | Qty. | MATERIAL / SPECIFICATIONS

STELLENBOSCH UNIVERSITY | 3 1:20 SCALE ON A | BASE ASSEMBLY

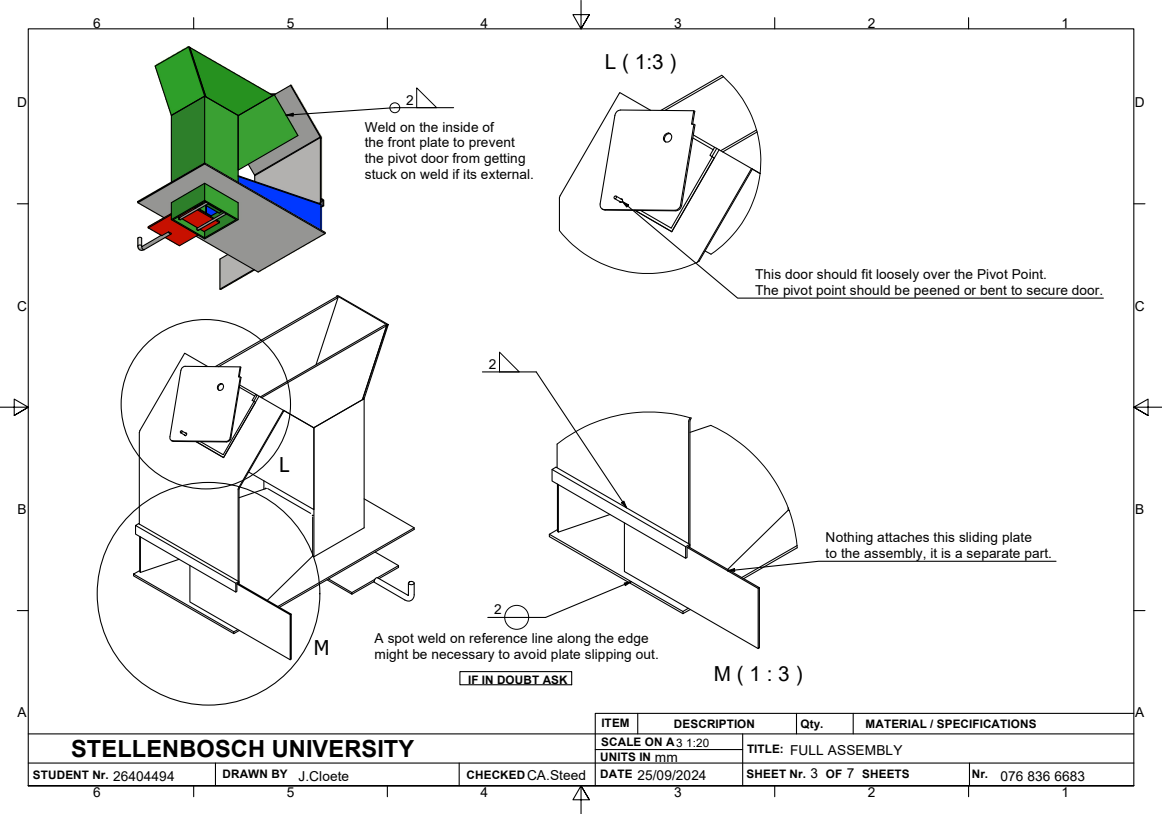
[picture p28: page 3]

Weld on the inside of
the front plate to prevent
the pivot door from getting
stuck on weld if its external.

This door should fit loosely over the Pivot Point.
The pivot point should be peened or bent to secure door.

Nothing attaches this sliding plate
to the assembly, it is a separate part.

A spot weld on reference line along the edge
might be necessary to avoid plate slipping out.

IF IN DOUBT ASK

ITEM | DESCRIPTION | Qty. | MATERIAL / SPECIFICATIONS

STELLENBOSCH UNIVERSITY | SCALE ON A 3 1:20

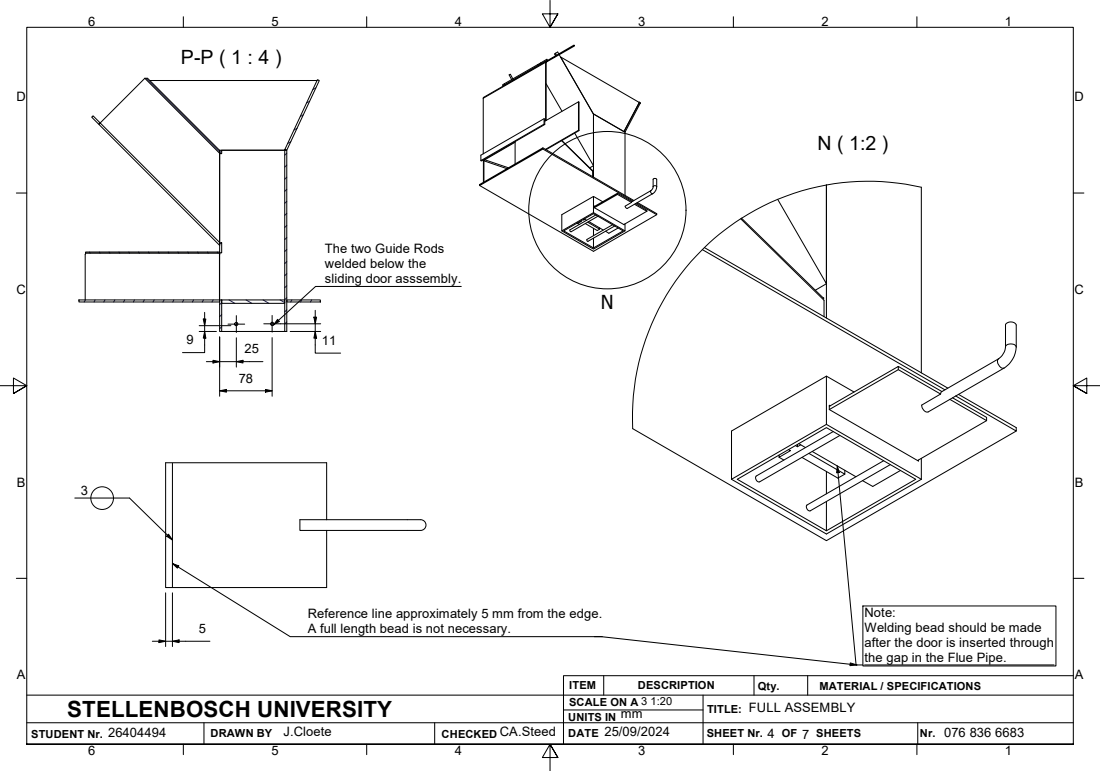
[picture p29: page 4]

The two Guide Rods
welded below the
sliding door asssembly.

Reference line approximately 5 mm from the edge.
A full length bead is not necessary.

Note:
Welding bead should be made
after the door is inserted through
the gap in the Flue Pipe.

ITEM | DESCRIPTION | Qty. | MATERIAL / SPECIFICATIONS

STELLENBOSCH UNIVERSITY | 3 1:20 SCALE ON A

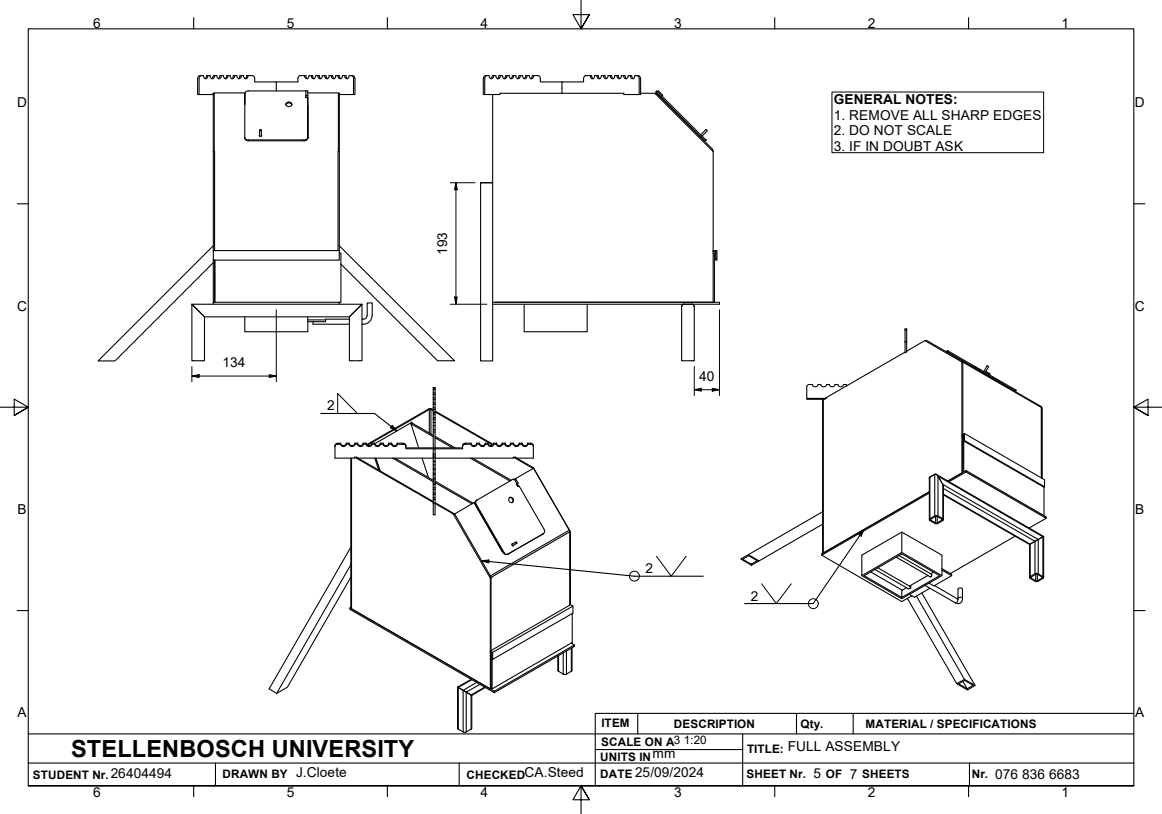
[picture p30: page 5]

GENERAL NOTES:
1. REMOVE ALL SHARP EDGES
2. DO NOT SCALE
3. IF IN DOUBT ASK

ITEM | DESCRIPTION | Qty. | MATERIAL / SPECIFICATIONS

STELLENBOSCH UNIVERSITY | 3 1:20 SCALE ON A

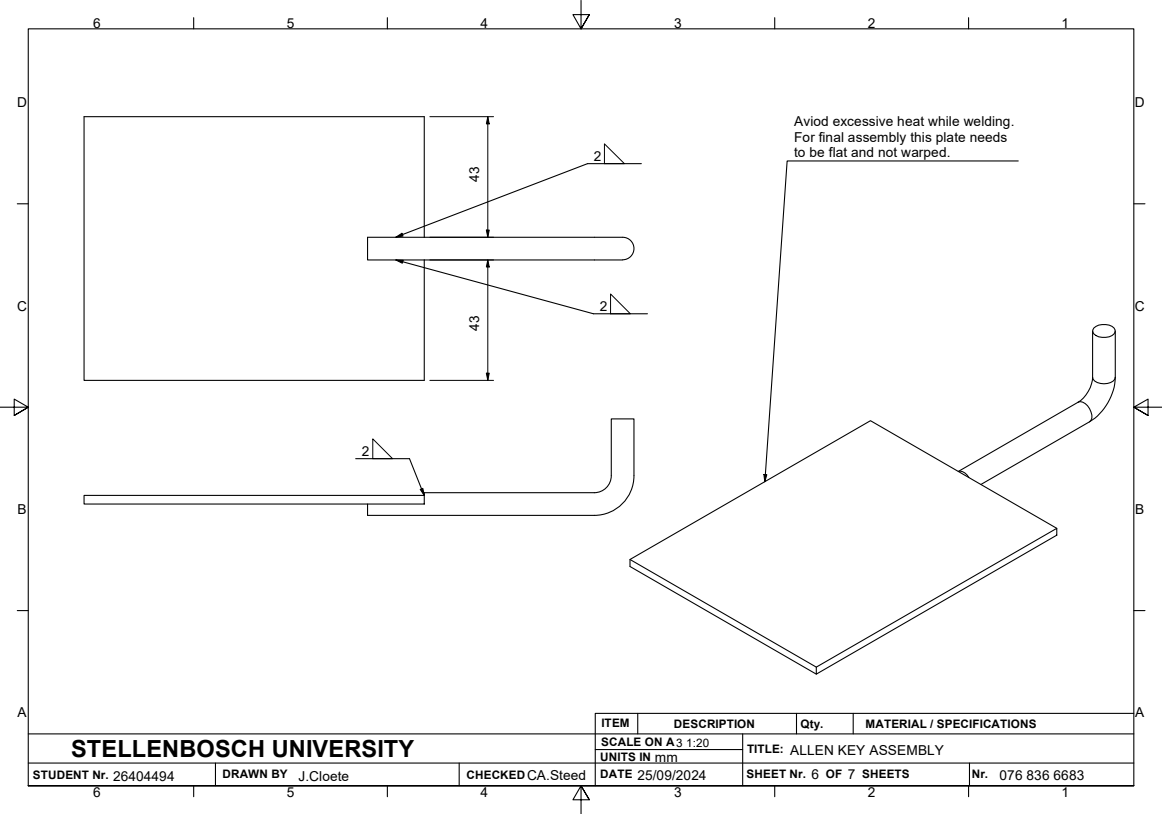
[picture p31: page 6]

Aviod excessive heat while welding.
For final assembly this plate needs
to be flat and not warped.

ITEM | DESCRIPTION | Qty. | MATERIAL / SPECIFICATIONS

STELLENBOSCH UNIVERSITY | SCALE ON A 3 1:20 | ALLEN KEY ASSEMBLY

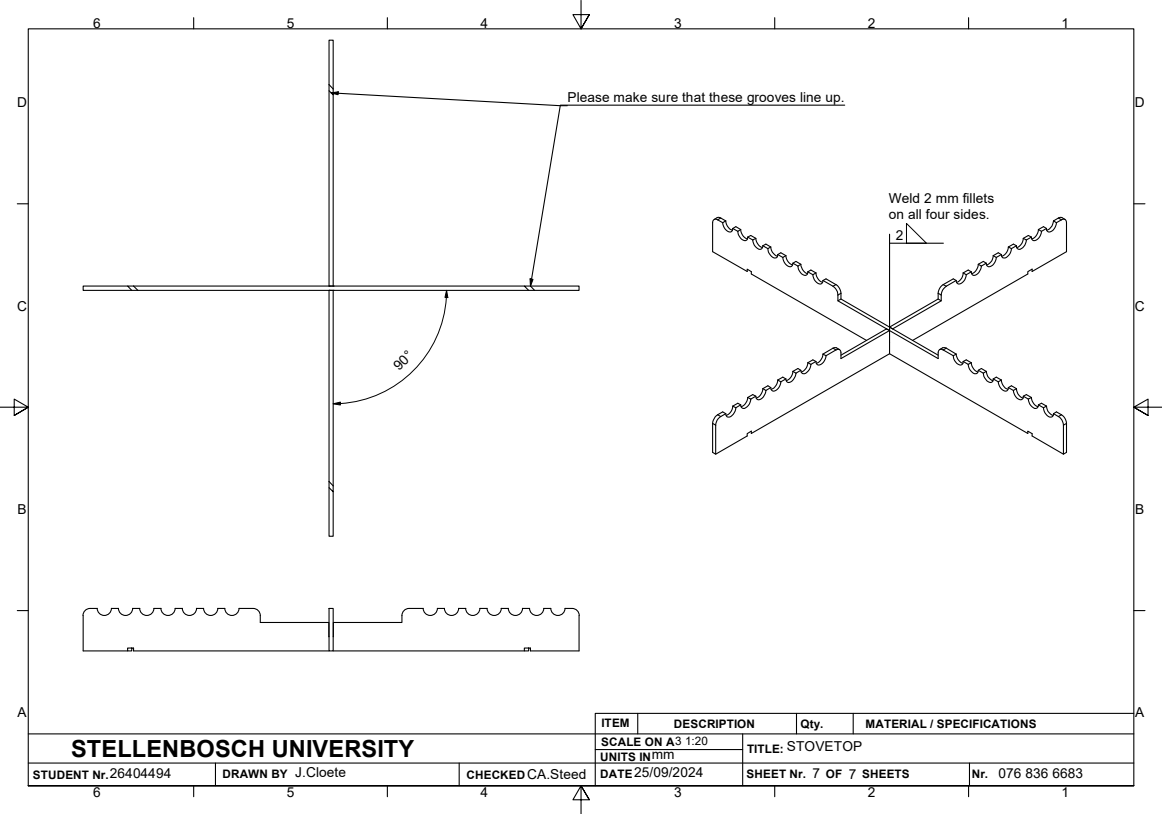
[picture p32: page 7]

Please make sure that these grooves line up.

Weld 2 mm fillets
on all four sides.

ITEM | DESCRIPTION | Qty. | MATERIAL / SPECIFICATIONS

STELLENBOSCH UNIVERSITY | 3 1:20 SCALE ON A | STOVETOP
