Acadevic/RocketStoveDesign/CAD/CAD Final Design/RS3other/Full-Assembly.pdf

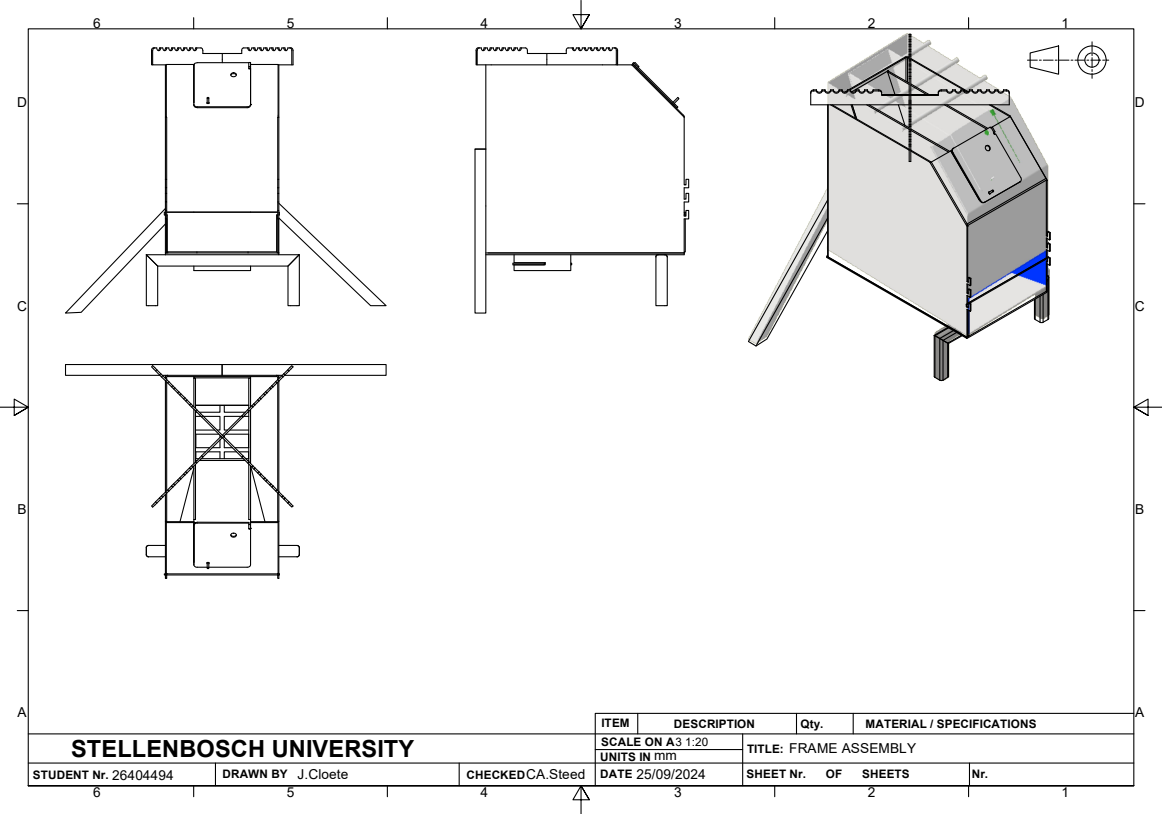
[picture p35: page 1]
STUDENT Nr.; DRAWN BY; CHECKED; UNITS IN; SHEET Nr.; SHEETS

ITEM | DESCRIPTION | Qty. | MATERIAL / SPECIFICATIONS

STELLENBOSCH UNIVERSITY | SCALE ON A 3 1:20 | TITLE: FRAME ASSEMBLY

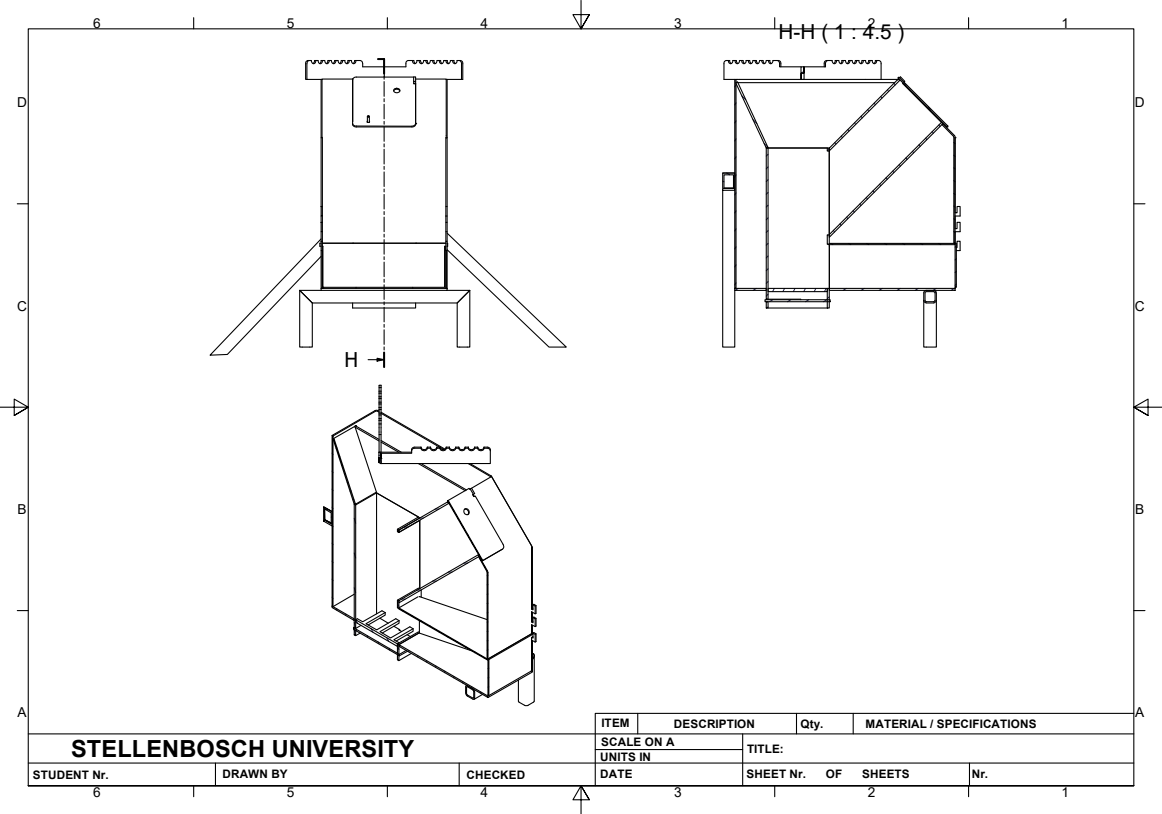
[picture p36: page 2]
STUDENT Nr.; DRAWN BY; CHECKED; UNITS IN; SHEET Nr.; SHEETS

ITEM | DESCRIPTION | Qty. | MATERIAL / SPECIFICATIONS

STELLENBOSCH UNIVERSITY | SCALE ON A | TITLE:
