Acadevic/RocketStoveDesign/CAD/CAD Final Design/Workshop Blueprints/Workshop-Parts.pdf

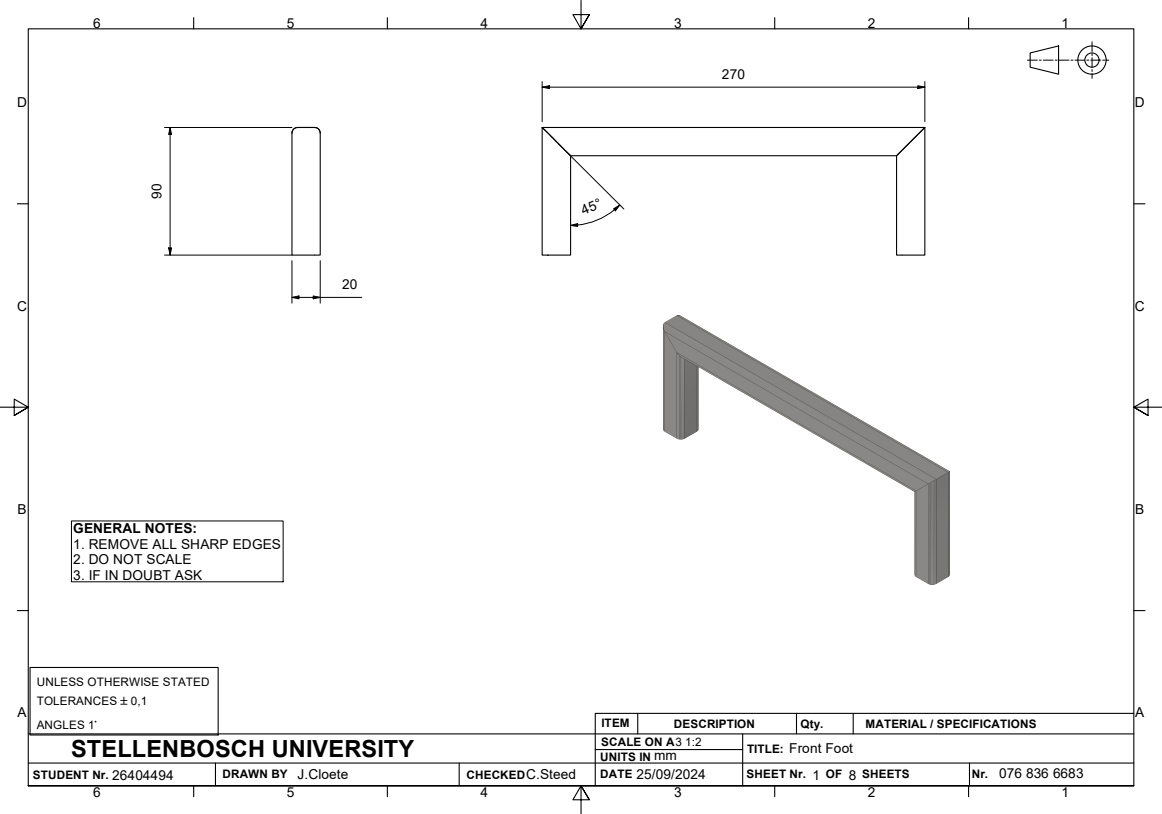
[picture p37: page 1]
STUDENT Nr.; DRAWN BY; CHECKED; UNITS IN; SHEET Nr.; SHEETS

GENERAL NOTES:
1. REMOVE ALL SHARP EDGES
2. DO NOT SCALE
3. IF IN DOUBT ASK

UNLESS OTHERWISE STATED
TOLERANCES `0,1
ANGLES 1~

ITEM | DESCRIPTION | Qty. | MATERIAL / SPECIFICATIONS

STELLENBOSCH UNIVERSITY | SCALE ON A 3 1:2 | TITLE: Front Foot

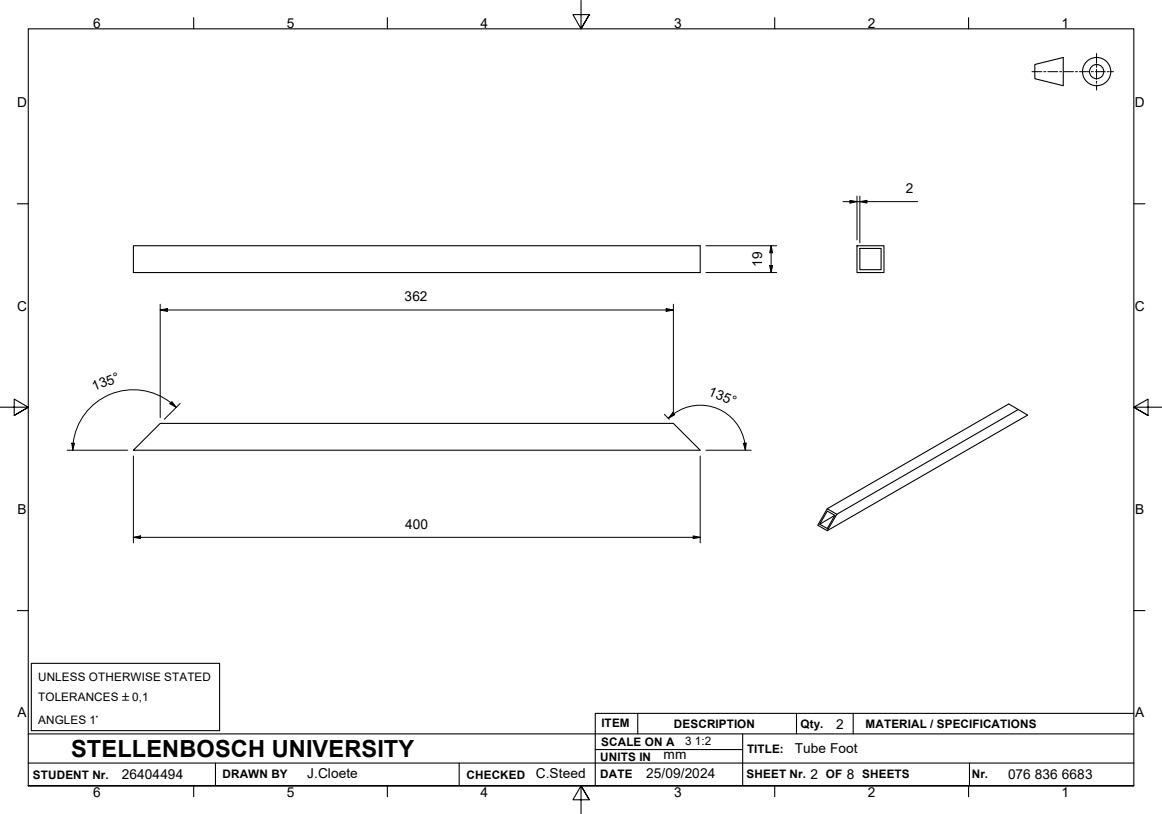
[picture p38: page 2]

UNLESS OTHERWISE STATED
TOLERANCES `0,1
ANGLES 1~

ITEM | DESCRIPTION | Qty. 2 | MATERIAL / SPECIFICATIONS

STELLENBOSCH UNIVERSITY | 3 1:2 SCALE ON A | Tube Foot

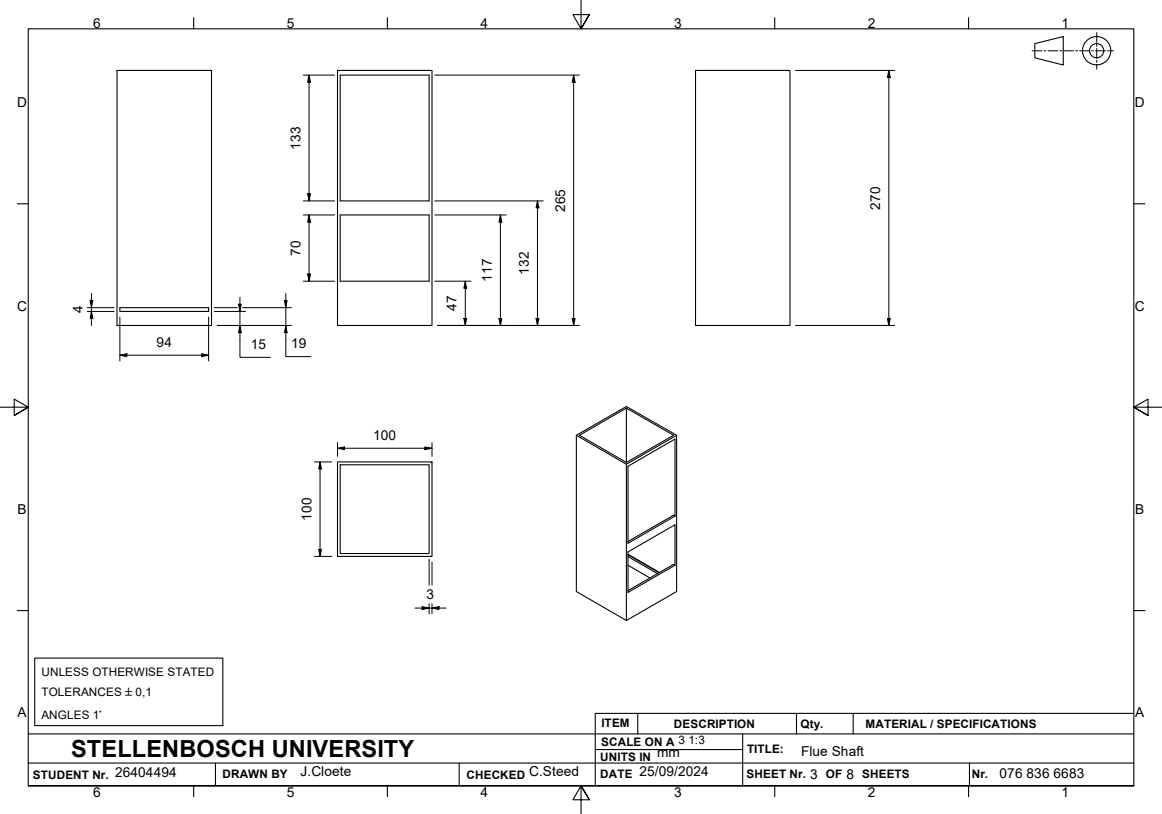
[picture p39: page 3]
ANGLES 1~

UNLESS OTHERWISE STATED
TOLERANCES `0,1

ITEM | DESCRIPTION | Qty. | MATERIAL / SPECIFICATIONS

STELLENBOSCH UNIVERSITY | 3 1:3 SCALE ON A | Flue Shaft

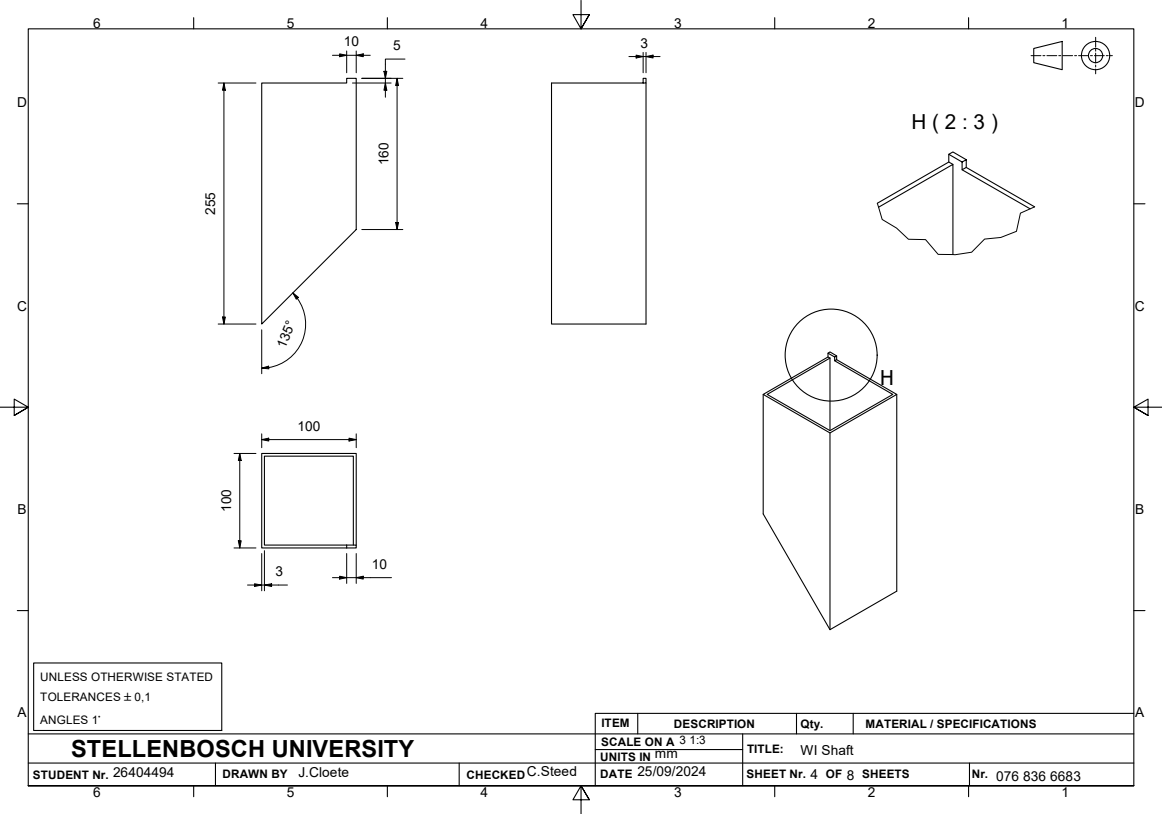
[picture p40: page 4]

UNLESS OTHERWISE STATED
TOLERANCES `0,1
ANGLES 1~

ITEM | DESCRIPTION | Qty. | MATERIAL / SPECIFICATIONS

STELLENBOSCH UNIVERSITY | 3 1:3 SCALE ON A | WI Shaft

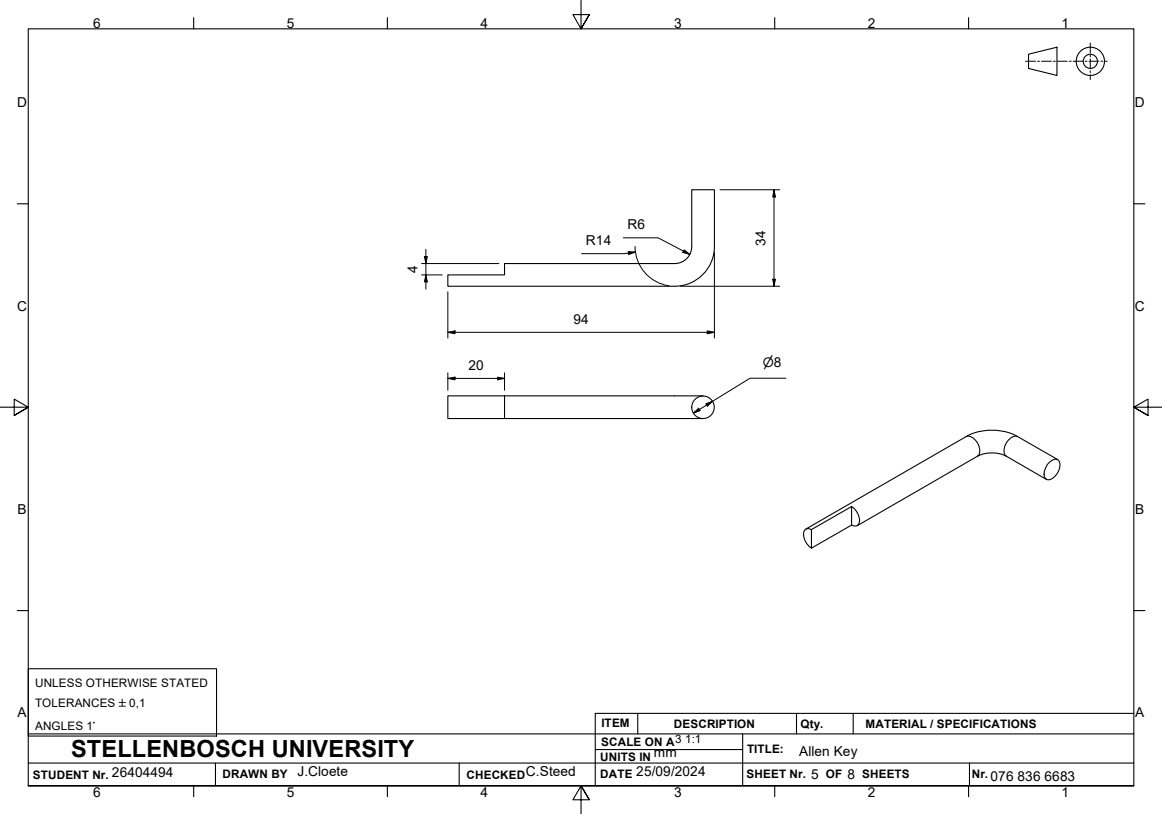
[picture p41: page 5]

UNLESS OTHERWISE STATED
TOLERANCES `0,1
ANGLES 1~

ITEM | DESCRIPTION | Qty. | MATERIAL / SPECIFICATIONS

STELLENBOSCH UNIVERSITY | 3 1:1 SCALE ON A | Allen Key

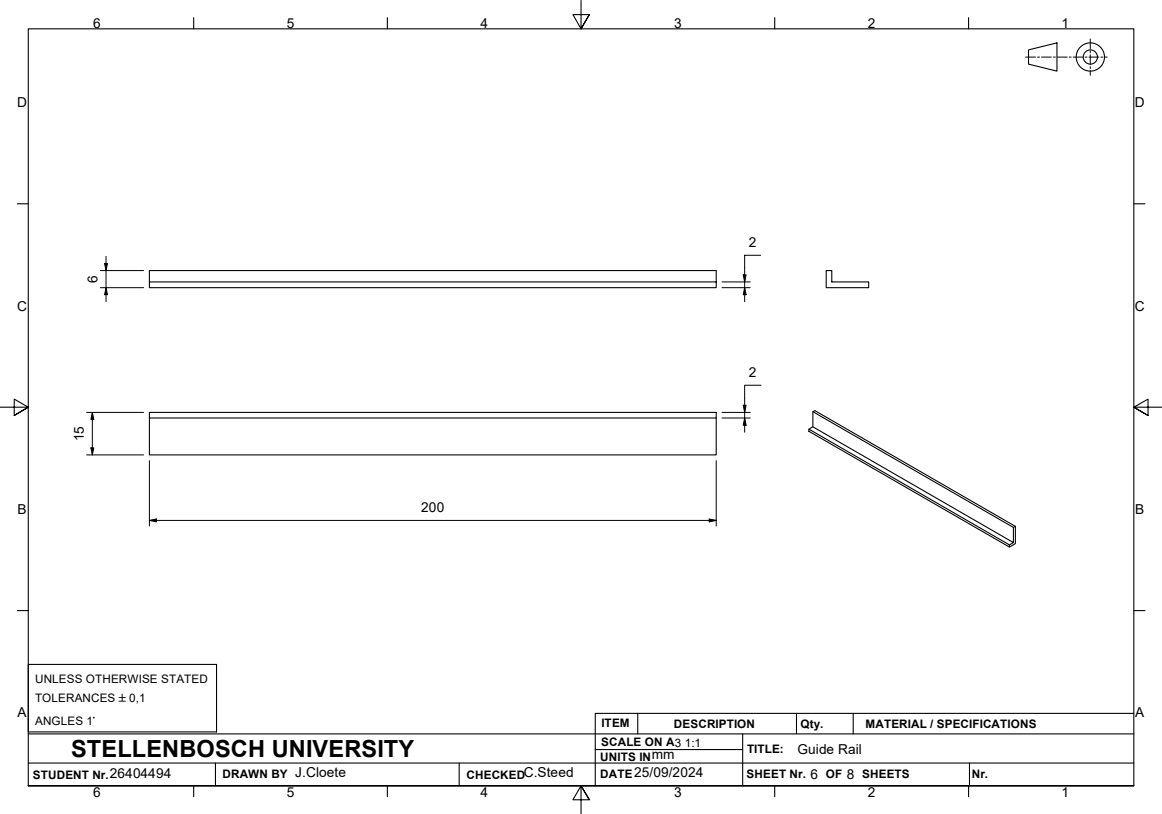
[picture p42: page 6]

UNLESS OTHERWISE STATED
TOLERANCES `0,1
ANGLES 1~

ITEM | DESCRIPTION | Qty. | MATERIAL / SPECIFICATIONS

STELLENBOSCH UNIVERSITY | SCALE ON A 3 1:1 | Guide Rail

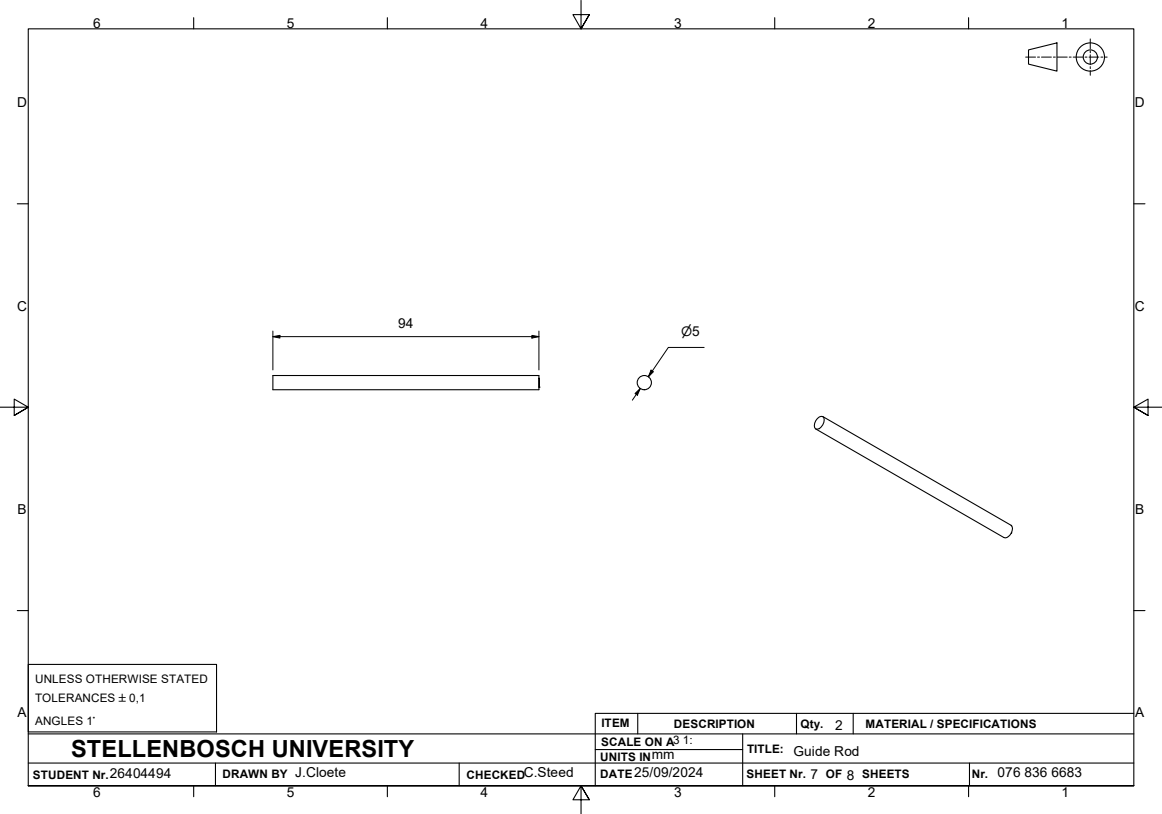
[picture p43: page 7]

UNLESS OTHERWISE STATED
TOLERANCES `0,1
ANGLES 1~

ITEM | DESCRIPTION | Qty. 2 | MATERIAL / SPECIFICATIONS

STELLENBOSCH UNIVERSITY | 3 1: SCALE ON A | Guide Rod

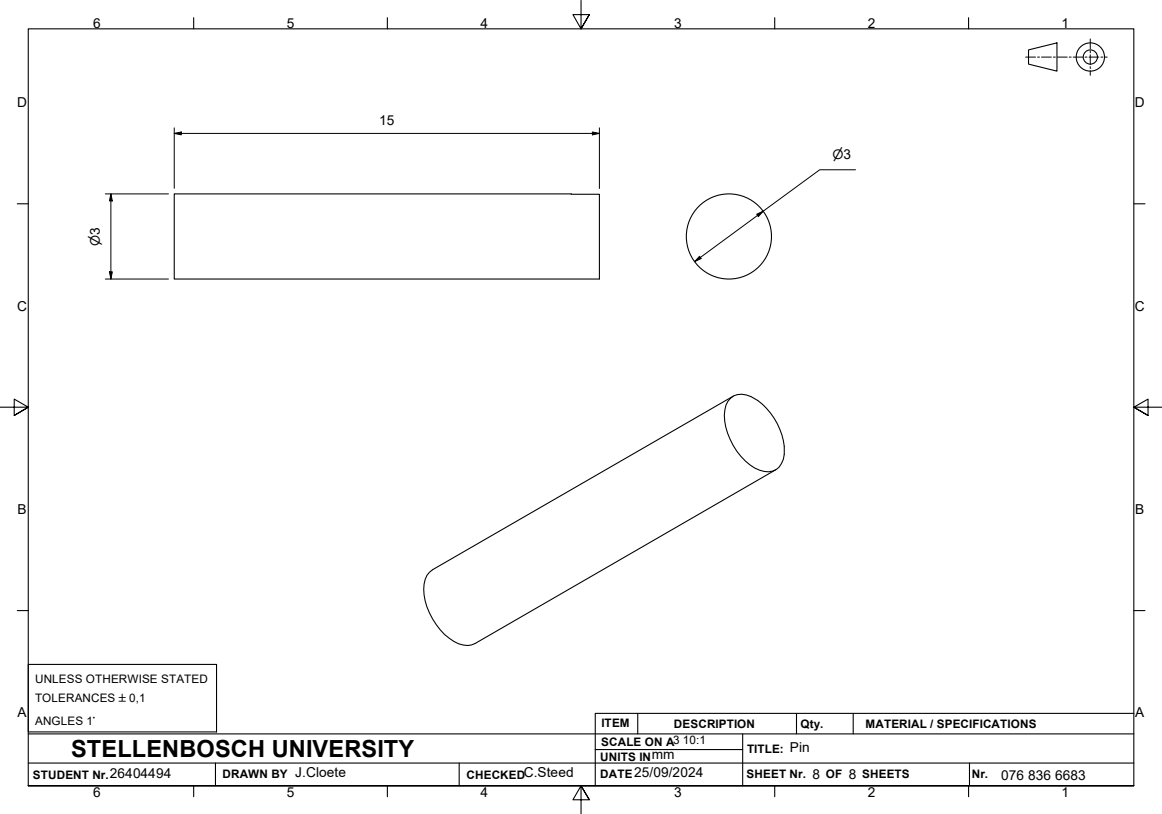
[picture p44: page 8]

UNLESS OTHERWISE STATED
TOLERANCES `0,1
ANGLES 1~

ITEM | DESCRIPTION | Qty. | MATERIAL / SPECIFICATIONS

STELLENBOSCH UNIVERSITY | 3 10:1 SCALE ON A | Pin
