Acadevic/RocketStoveDesign/CAD/CAD Final Design/RS3other/Full-Assembly1.pdf

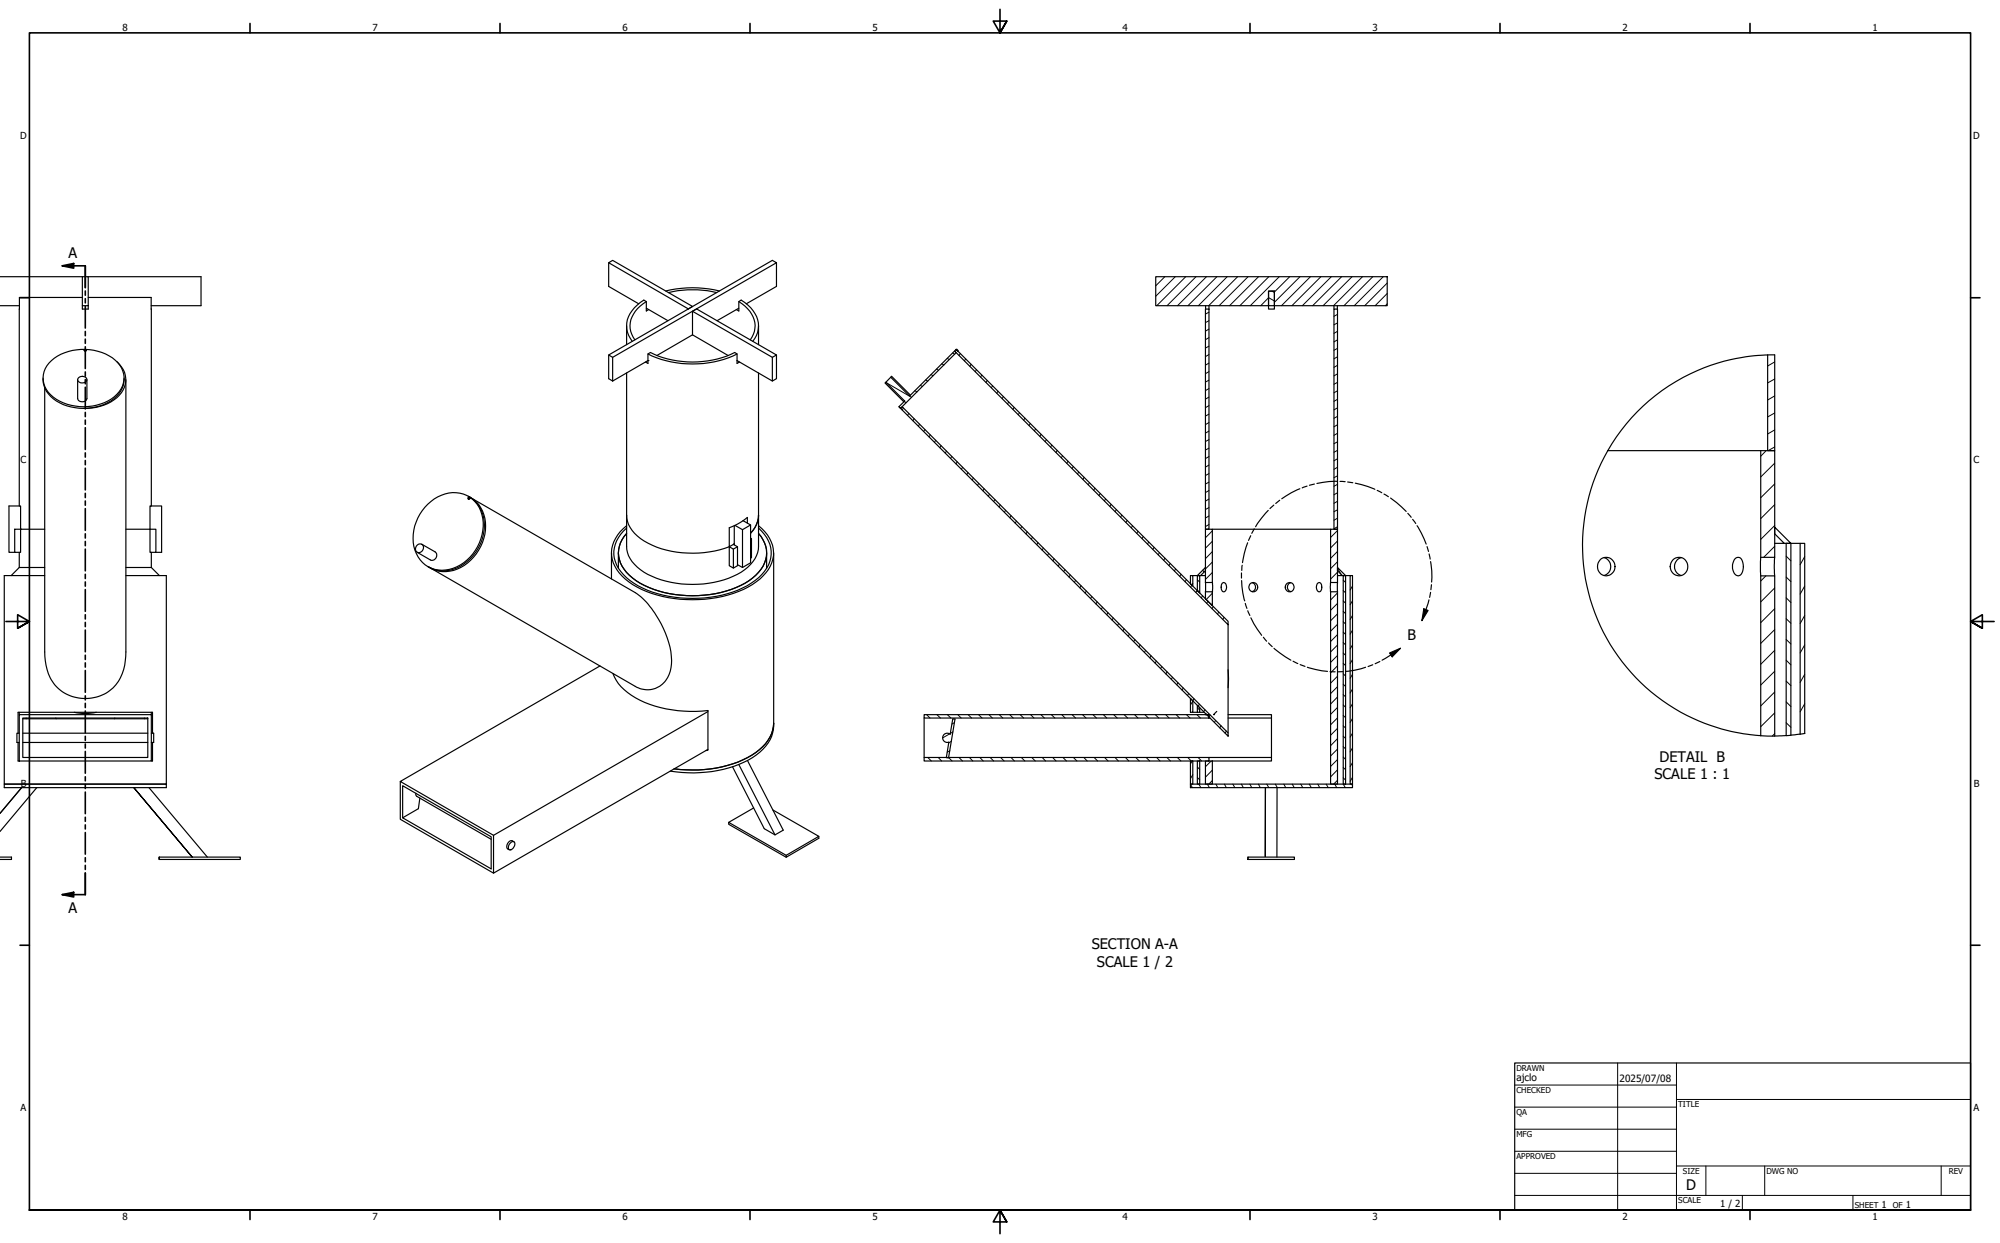
[picture p45: page 1]
SECTION A-A SCALE 1 / 2; DETAIL B SCALE 1 : 1

DRAWN ajclo | 2025/07/08

CHECKED

MFG

APPROVED

SIZE D | DWG NO | REV

SCALE 1 / 2 | | SHEET 1 OF 1
