Acadevic/RocketStoveDesign/CAD/CAD Final Design/RS3other/Side By Side V2 vs V3.pdf

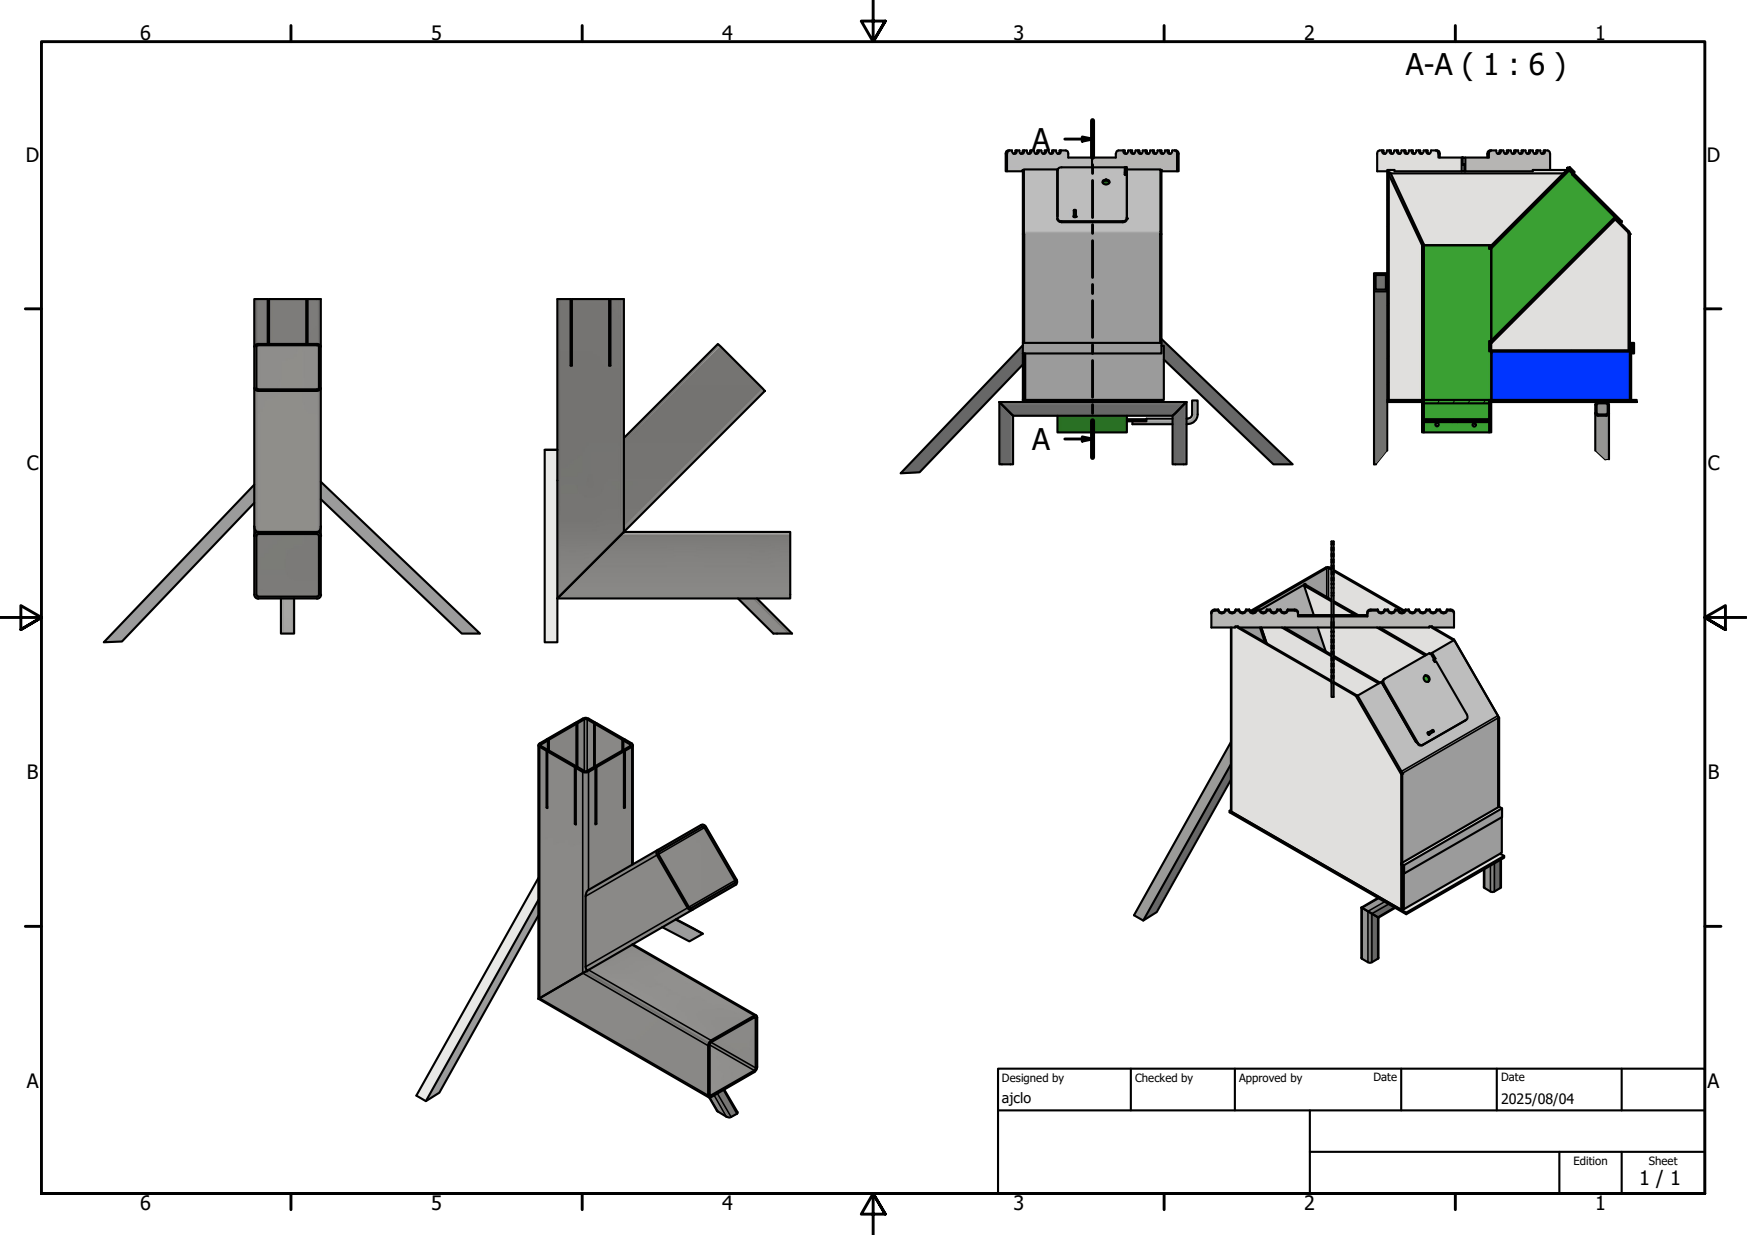
[picture p46: page 1]
Designed by; Checked by; Approved by; Date
