Acadevic/RocketStoveDesign/CAD/CAD Final Design/RS3other/Side byu side.pdf

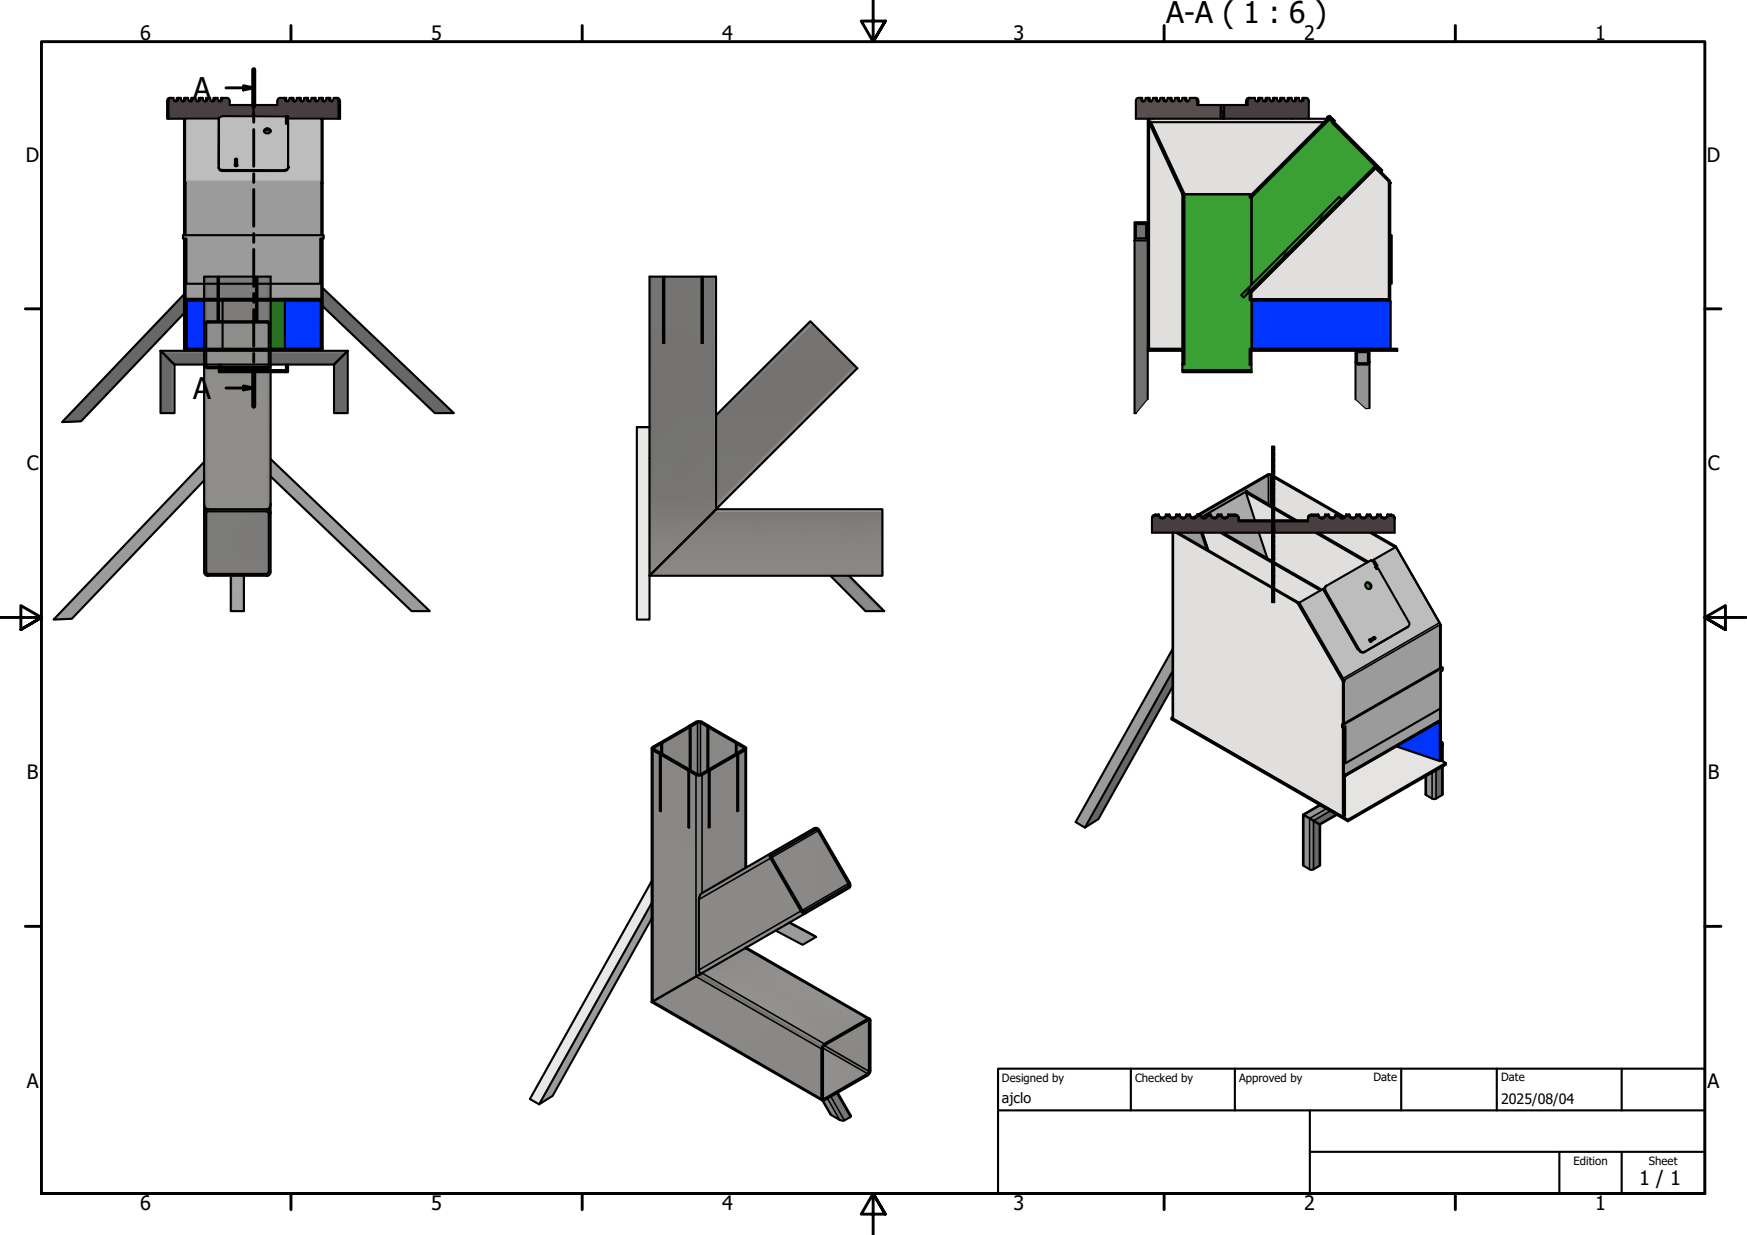
[picture p47: page 1]
Designed by; Checked by; Approved by; Date
