Acadevic/RocketStoveDesign/CAD/Drawing Templates-20240528 (1)/Stellenbosch A3 extenstion.pdf

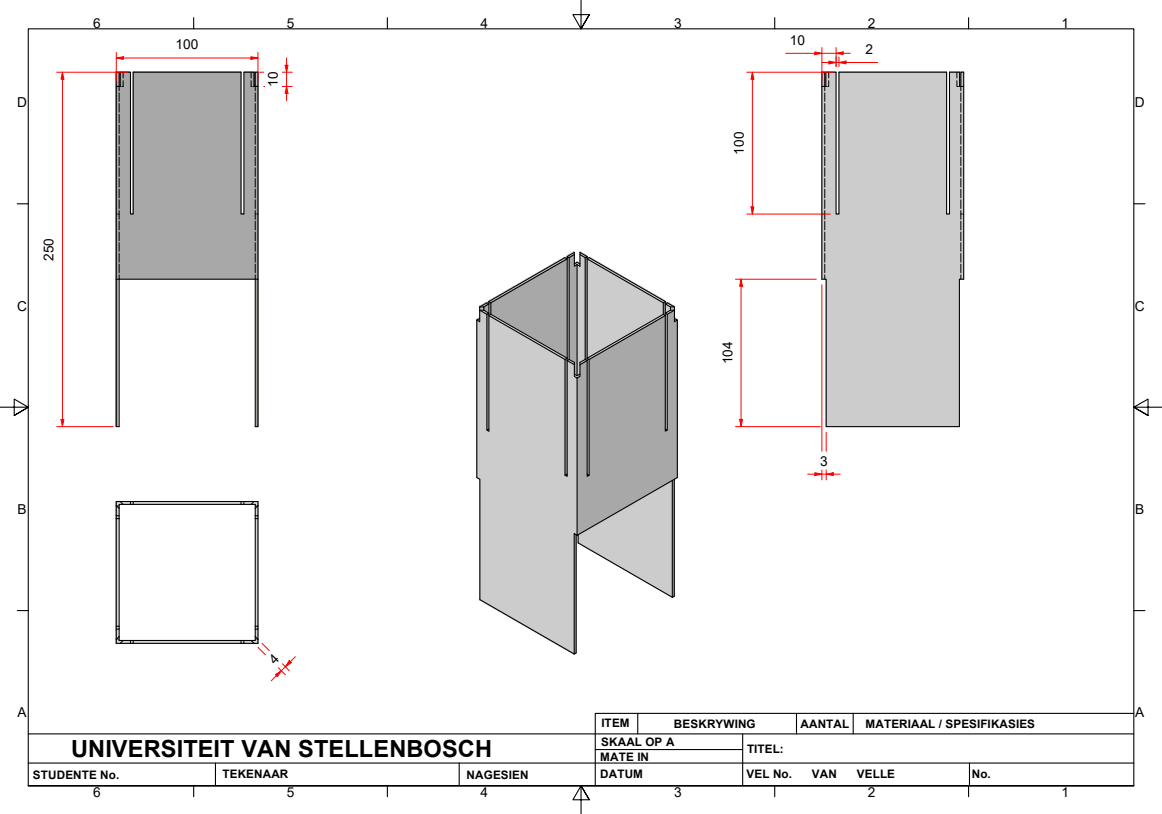
[picture p48: page 1]
STUDENTE No.; TEKENAAR; NAGESIEN; MATE IN; VEL No.; VAN; VELLE

ITEM | BESKRYWING | AANTAL | MATERIAAL / SPESIFIKASIES

UNIVERSITEIT VAN STELLENBOSCH | SKAAL OP A | TITEL:
