Acadevic/RocketStoveDesign/CAD/CAD Prototype 2/RS2_Assembly.pdf

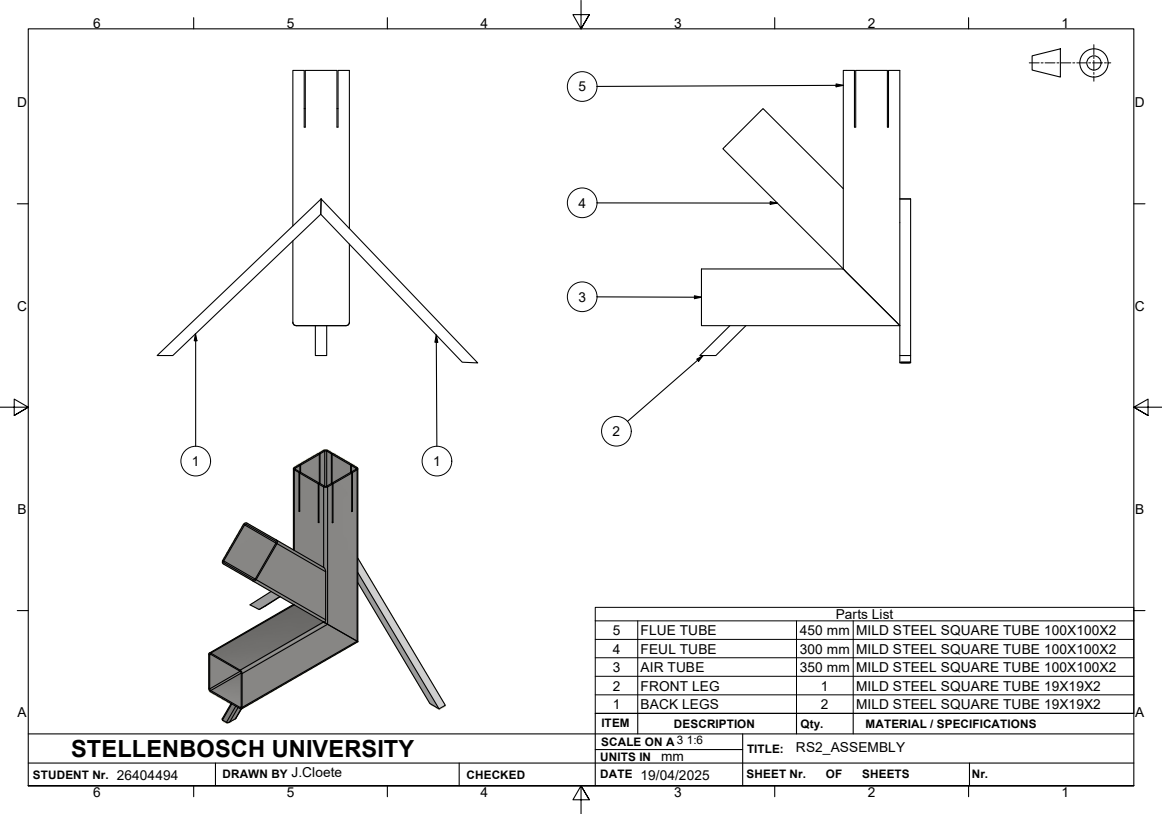
[picture p49: page 1]
Parts List; STUDENT Nr.; DRAWN BY; CHECKED; UNITS IN; SHEET Nr.; SHEETS

5 | FLUE TUBE | 450 mm | MILD STEEL SQUARE TUBE 100X100X2
4 | FEUL TUBE | 300 mm | MILD STEEL SQUARE TUBE 100X100X2
3 | AIR TUBE | 350 mm | MILD STEEL SQUARE TUBE 100X100X2
2 | FRONT LEG | 1 | MILD STEEL SQUARE TUBE 19X19X2
1 | BACK LEGS | 2 | MILD STEEL SQUARE TUBE 19X19X2
ITEM | DESCRIPTION | Qty. | MATERIAL / SPECIFICATIONS

STELLENBOSCH UNIVERSITY | 3 1:6 SCALE ON A | RS2_ASSEMBLY TITLE:

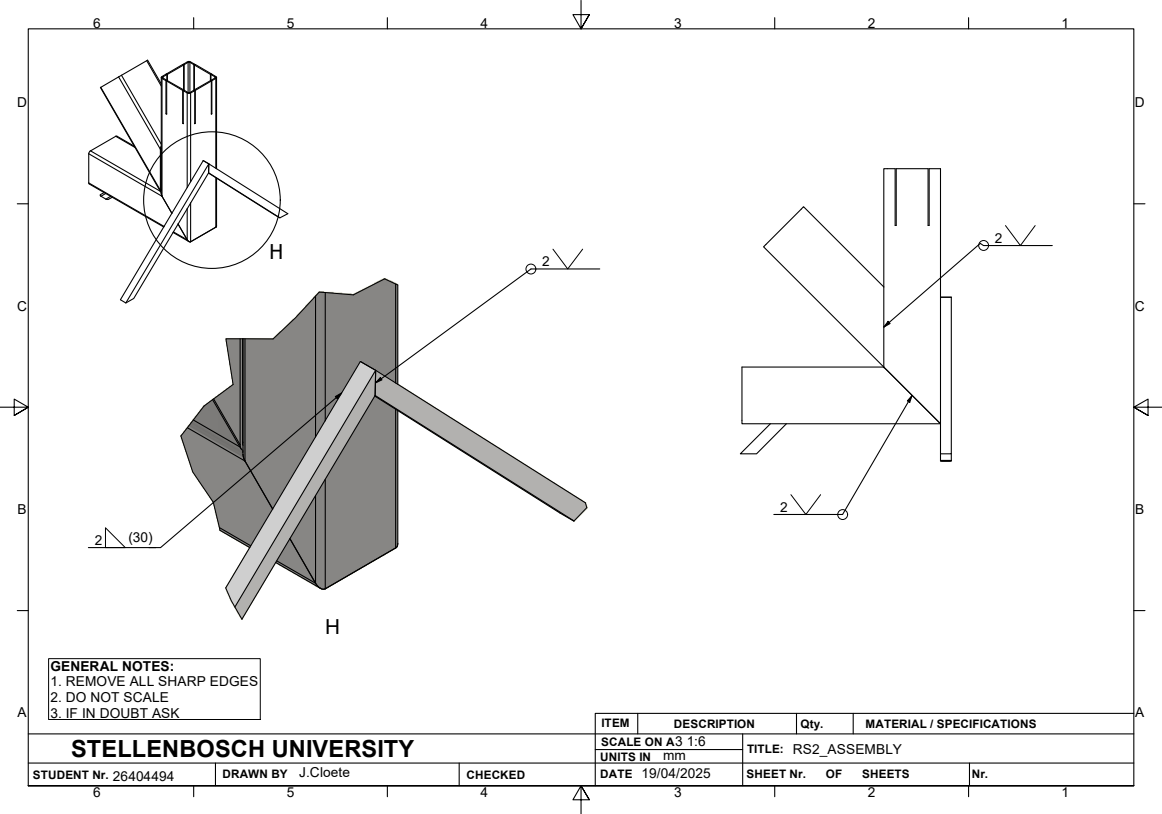
[picture p50: page 2]
STUDENT Nr.; DRAWN BY; CHECKED; UNITS IN; SHEET Nr.; SHEETS

GENERAL NOTES:
1. REMOVE ALL SHARP EDGES
2. DO NOT SCALE
3. IF IN DOUBT ASK

ITEM | DESCRIPTION | Qty. | MATERIAL / SPECIFICATIONS

STELLENBOSCH UNIVERSITY | 3 1:6 SCALE ON A | TITLE: RS2_ASSEMBLY
