Acadevic/RocketStoveDesign/CAD/CAD Prototype 2/RS2_Parts.pdf

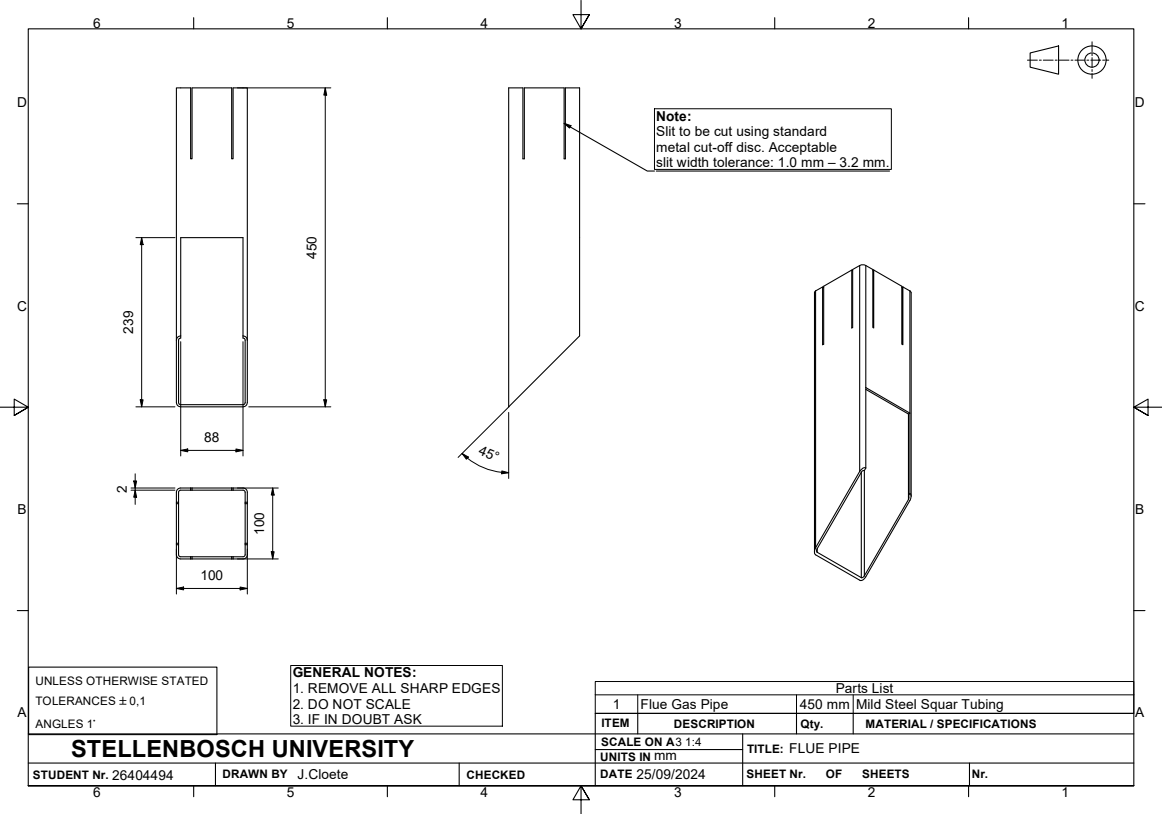
[picture p51: page 1]
Parts List; STUDENT Nr.; DRAWN BY; CHECKED; UNITS IN; SHEET Nr.; SHEETS

Note:
Slit to be cut using standard
metal cut-off disc. Acceptable
slit width tolerance: 1.0 mm – 3.2 mm.

GENERAL NOTES:
1. REMOVE ALL SHARP EDGES
2. DO NOT SCALE
3. IF IN DOUBT ASK

UNLESS OTHERWISE STATED
TOLERANCES `0,1
ANGLES 1~

1 | Flue Gas Pipe | 450 mm | Mild Steel Squar Tubing
ITEM | DESCRIPTION | Qty. | MATERIAL / SPECIFICATIONS

STELLENBOSCH UNIVERSITY | SCALE ON A 3 1:4 | TITLE: FLUE PIPE

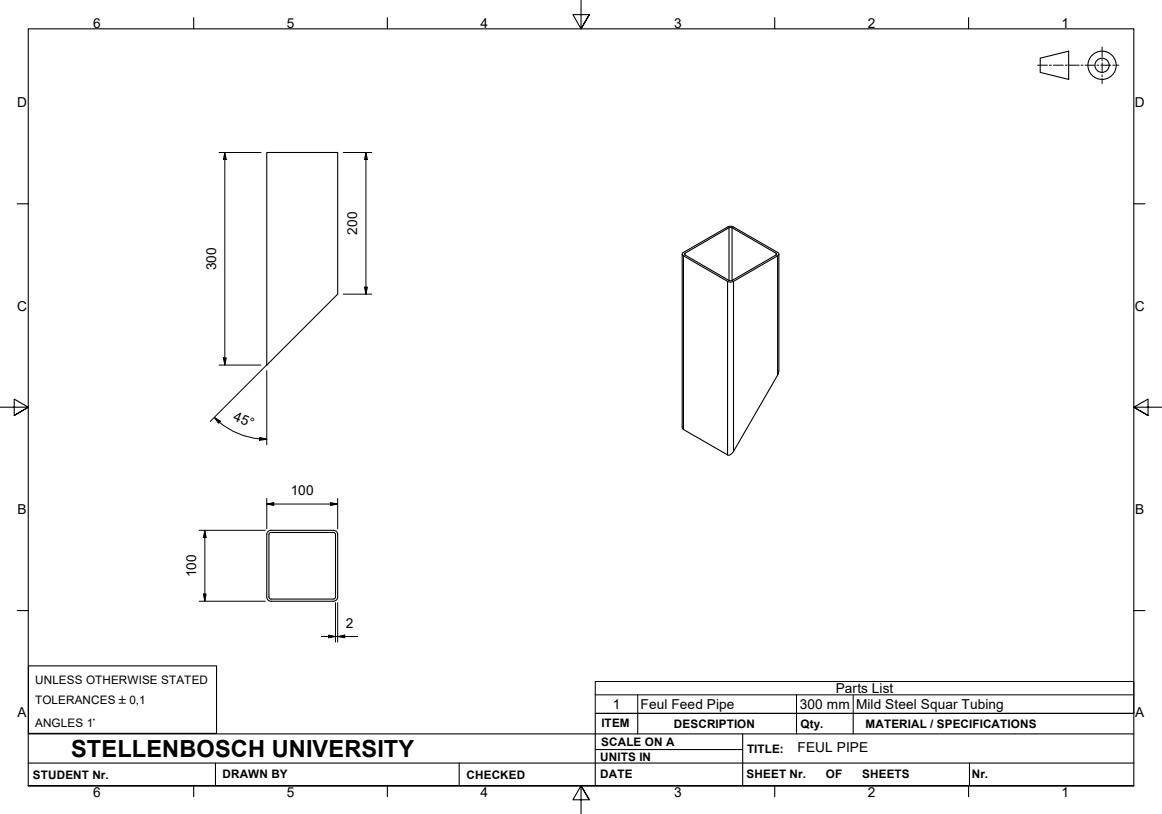
[picture p52: page 2]
Parts List

UNLESS OTHERWISE STATED
TOLERANCES `0,1
ANGLES 1~

1 | Feul Feed Pipe | 300 mm | Mild Steel Squar Tubing
ITEM | DESCRIPTION | Qty. | MATERIAL / SPECIFICATIONS

STELLENBOSCH UNIVERSITY | SCALE ON A | FEUL PIPE

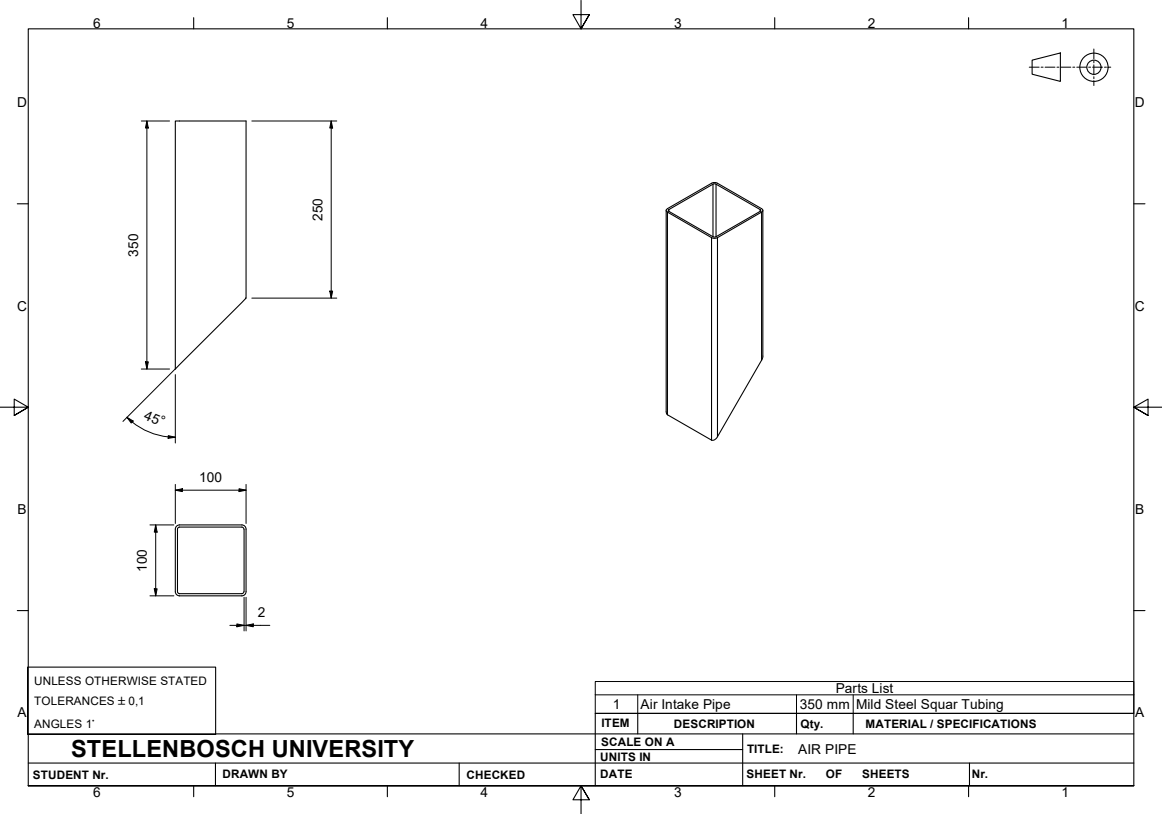
[picture p53: page 3]
Parts List

UNLESS OTHERWISE STATED
TOLERANCES `0,1
ANGLES 1~

1 | Air Intake Pipe | 350 mm | Mild Steel Squar Tubing
ITEM | DESCRIPTION | Qty. | MATERIAL / SPECIFICATIONS

STELLENBOSCH UNIVERSITY | SCALE ON A | AIR PIPE

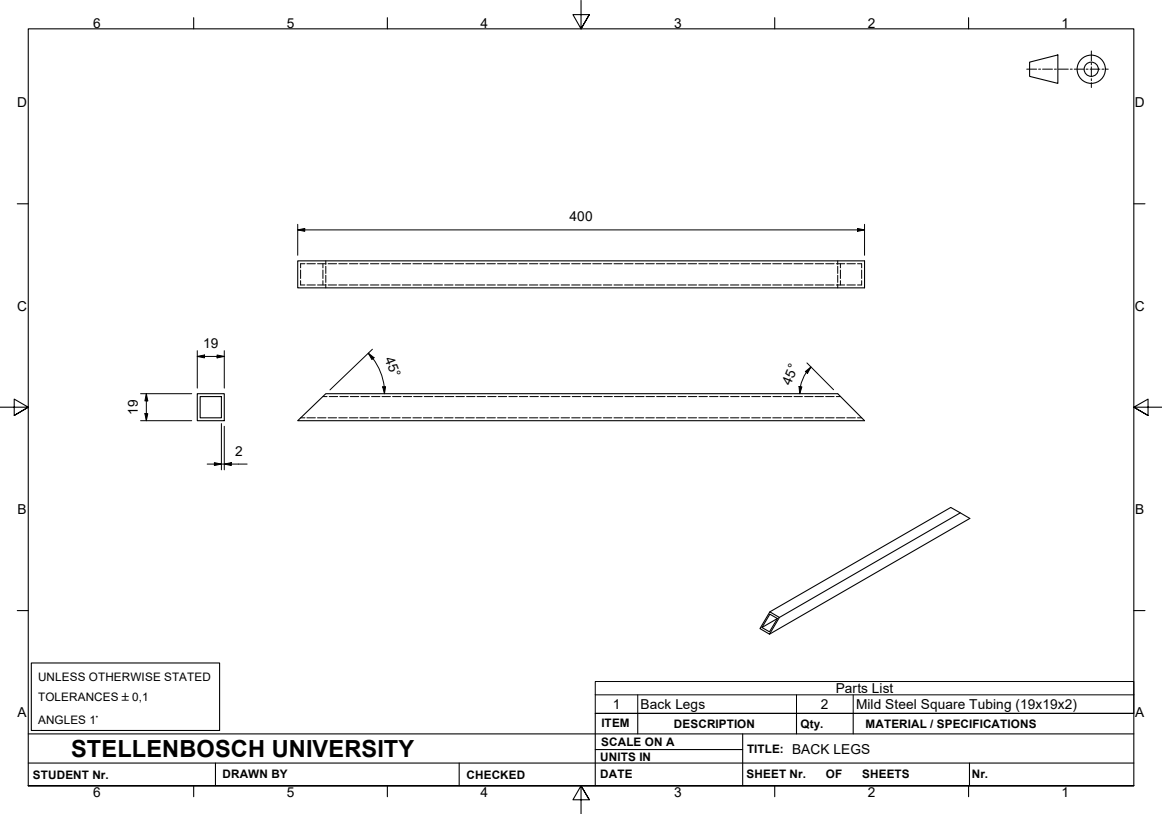
[picture p54: page 4]
Parts List

UNLESS OTHERWISE STATED
TOLERANCES `0,1
ANGLES 1~

1 | Back Legs | 2 | Mild Steel Square Tubing (19x19x2)
ITEM | DESCRIPTION | Qty. | MATERIAL / SPECIFICATIONS

STELLENBOSCH UNIVERSITY | SCALE ON A | BACK LEGS

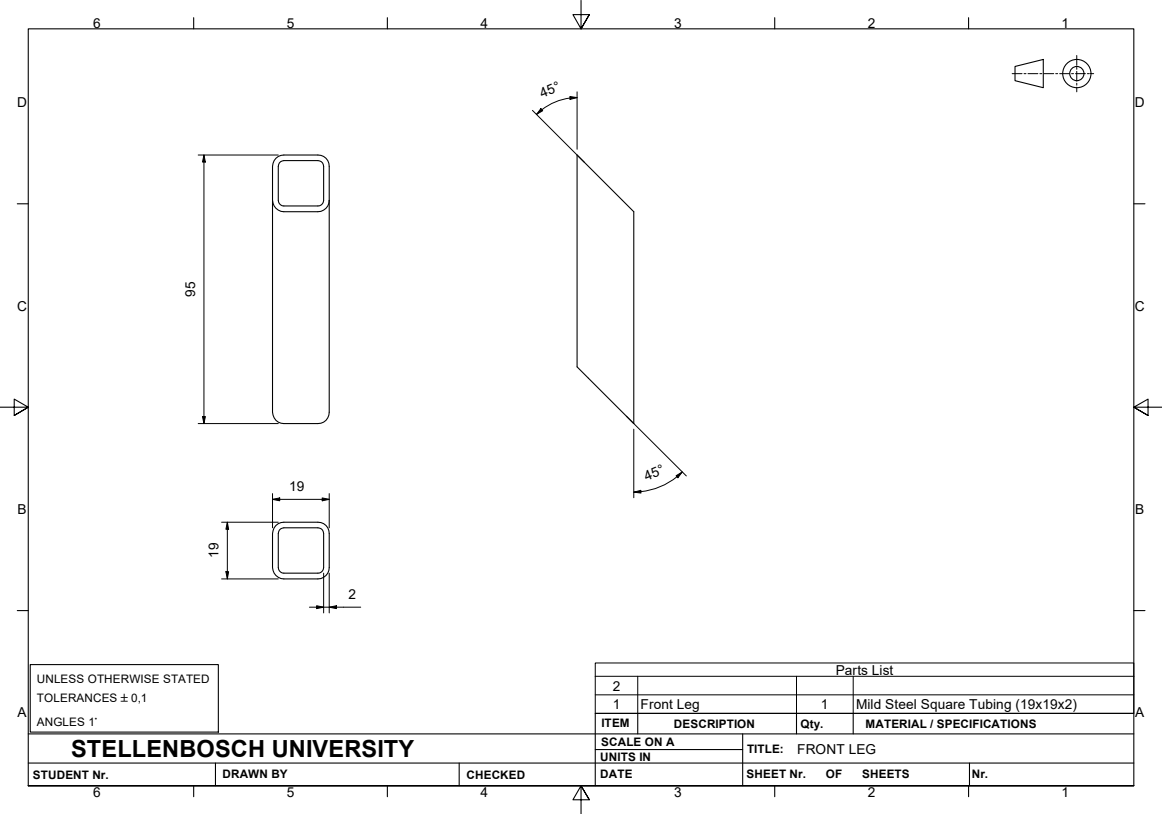
[picture p55: page 5]
Parts List

UNLESS OTHERWISE STATED
TOLERANCES `0,1
ANGLES 1~

1 | Front Leg | 1 | Mild Steel Square Tubing (19x19x2)
ITEM | DESCRIPTION | Qty. | MATERIAL / SPECIFICATIONS

STELLENBOSCH UNIVERSITY | SCALE ON A | FRONT LEG
